nio40k/iBox-Printers-Nano/Nano ibox folder/www/packages/compressed/_svg/beam10cm_standing10x.stl

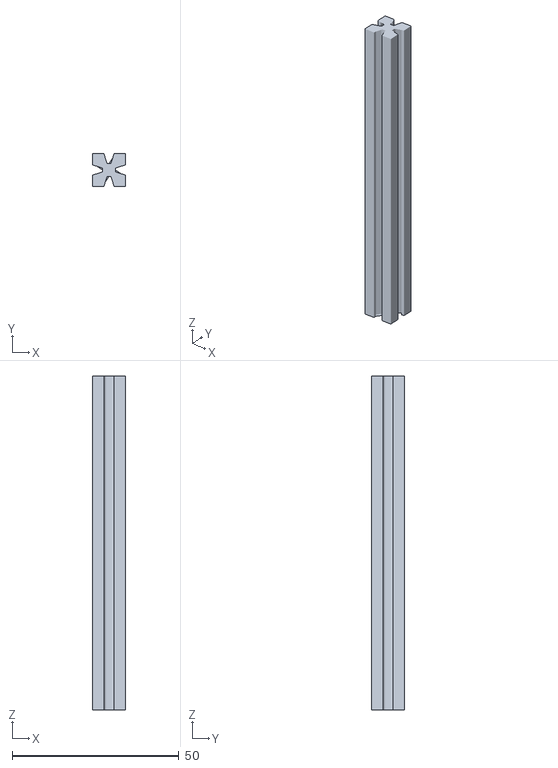
[picture p1: CAD file, 2016-02-06]
Nano ibox folder/www/packages/compressed/_svg/beam10cm_standing10x.stl
10.0 x 10.0 x 100.0
