nio40k/iBox-Printers-Nano/PCB Files/RLCD_SCH_28LED_v1p13p2.dxf

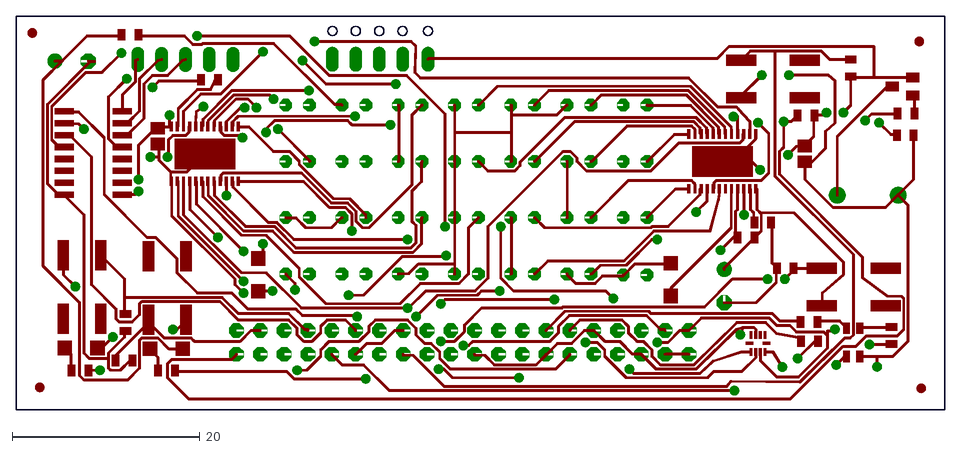
[picture p2: CAD file, 2016-02-06]
PCB Files/RLCD_SCH_28LED_v1p13p2.dxf
99.0 x 42.0
