nio40k/iBox-Printers-Nano/(list of files, cad)

Other CAD files:
Nano ibox folder/www/packages/compressed/_svg/.AppleDouble/beam10cm_standing10x.stl
Nano ibox folder/www/packages/compressed/_svg/.AppleDouble/linkBracelet_Fine.stl
Nano ibox folder/www/packages/compressed/_svg/.AppleDouble/OwlReDo1_fixed_sc.stl
