nio40k/iBox-Printers-Nano/Nano ibox folder/help/User_Instruction_Draft_2_5_15.htm

iBox Nano - User Guide

Updated 2/15/2015

Warnings:

The only way to damage the nano under normal operation is to spill resin on or in it.

What do I do if I spill resin on the printer?

Quickly remove the VAT and wipe off the resin with an absorbent paper towel or other cloth. You can use Alcohol to clean it. The more pure the Alcohol the better.

We have only damaged one Nano during thousands of test prints and that was by overfilling the VAT just a little too much and then not noticing it was overflowing during the first layer. Please under-fill the VAT. It is very easy to add resin with your 100mL squirt top resin bottles and difficult to remove resin. If we work together we can get through your natural fear of running out of resin. Once you are familiar with the printer it will be a non-issue.

Always clean the VAT bottom (underside where the VAT touches the top of the printer) and sides to make sure you do not have residual resin that will bond during a print. If you have or spill resin between the VAT bottom and printer top it will bond the two together during your print cycle. This is bad but usually not destructive. Remember that cured resin is basically a powerful glue.

What if I spill resin inside my Nano?

This is very bad. The resin will “cure” and bond everything together. Think of it as spilling superglue inside the printer. The buttons will be the first failure. The acrylic will discolor from the resin as well. The printer will likely still function from the GUI.

Safety:

What if I get resin on my hands?

Just wash them immediately.

Always wear eye protection when working with resin or any fluid that is not eye friendly. Please read the MSDS. Resin is generally safe, but be careful especially around children.

The MSDS (Material Safety Sheet) can be found here: http://www.makerjuice.com/docs/SubGPlus-MSDS.pdf

## I don't like reading, can I just watch how-to videos and stuff?

www.youtube.com/iboxprinters

## Where do I go for support if this incredible documentation incredibly fails me?

support.iboxprinters.com

We handle support through our support forum. Please let us explain why calling or sending us support email is less productive than a managed support forum:

1. Phone Support: Phone calls just piss everyone off. You wait on the phone just long enough to be fuming by the time we answer. The phone support staff get abused more than (insert inappropriate metaphor here). But the bottom line is that one person is helped, the wait time is long and uncontrollable, the service level is moderate at best.

2. Email Support: Email is at least asynchronous. You send it when you get a chance, we respond when we get a chance. All good so far. But email only helps 1:1 and knowledge is lost. Also delays in email support are usually only guaranteed at 24hr turn-around.

3. Forum Support: (our selected method): With a moderated support forum you can first search for your issue and if its common you could have an answer in seconds and be on your merry way. If you don't find a solution you can post a “new” question. Then the moderators and other friendly and helpful users can try to provide support and assistance. Your help session is logged for others to see and possibly be helped as well. The next big advantage to a support forum is search engine indexing. Thus people just banging in their issue in “google” can find the answer and find our support forum in seconds. This is what we like when we buy something and what we prefer when looking for support for our consumer electronic devices. We hope you join the forum and are happy with it. support.iboxprinters.com

General Operational Procedures:

1. Never fill the VAT more than half full with resin.

2. Seriously; Never fill the VAT more than half full with resin.

3. Always attempt to shut the Nano down gracefully if possible. It is a computer with an SSD and repeated “hard” power drops will reduce the devices reliable operation. Gracefully shutdown can be achieved from the GUI (Power Button) or by pressing and holding both theUP and DOWN buttons for >4 sec until it beeps multiple times. Shutdown takes 30-45 seconds, so watch the lights to make sure they have stopped blinking.

4. The network settings are displayed during boot time for N seconds - on the top of the printer where the VAT is placed. So until you are familiar with the Nano, specifically how to communicate with it, do not have the VAT in place while the printer is booting.

5. The Nano takes about 2 minutes to boot up after connecting USB power. It will beep and cycle all indicator lights at boot.

6. The Nano takes about 30 seconds to power down after holding-UP+DOWN > 5sec OR using reboot or shutdown commands from the GUI (i.e. Power button). Please do not disconnect or interrupt the shutdown process, you should wait until the Green LED on the lowest layer of the printer turns off.

7. The Nano has a microB USB plug and cable, but it is used only to power the unit. It will not enumerate on your computer as a USB device. All connectivity is achieved via WiFi.

8. You can power the Nano from almost any USB power source.

9. The Z axis on the nano has a Carriage that holds the Build Plate. The Build Plate needs to be lowered until it is touching the VAT surface before you initiate a Print. Try this a few times with no resin in the VAT to get comfortable with the process. Once you have “homed” this position and selected print, the position will be remembered. Once homed the Build Plate will lower to the print position by holding the “Down” button for several seconds until you hear a double beep. After a print completes the build plate will motor up automatically to a height that will allow easy removal of the Build Plate from the Carriage.

10. The buttons on the front of the Nano are multi-use:

Button [Print]:

• “quick press” -> (starts/stops printing) Starts a print. If a print is in process, it will stop the print job.

• “long press >4sec” -> Initiates WPS to associate with a WPS enable AP. See section on connecting the nano to the network.

• If “quick pressed” while the Carriage is in motion it will stop the Carriage motion.

Button [UP / DOWN]

• “quick press” -> Moves carriage UP / DOWN one layer height OR if the carriage is currently moving it will STOP the movement.

• “long press >1sec” -> Double Beeps -> Starts the carriage moving for a long distance (configurable in Nano GUI settings)

• Press BOTH UP+DOWN buttons for >4sec -> Gracefully shuts down the printer. You can also shutdown or reboot from the Nano GUI.

Getting your Nano on the network

## There are a few ways to get your Nano connected to the network:

• WPS - Pressing the WPS button on your Access Point (assuming it has this feature) and then pressing and holding the “Print” button on the Nano until you hear multiple beeps will put both devices in WPS mode and they should automatically connect.

• USB Stick : Rebooting with a USB Stick in the Nano with a minimum of the file wpa_supplicant.conf.txt that has been edited to include your network information.

• GUI+WiFi : Connect the Nano to a monitor [HDMI or Composite NTSC], and insert a USB Hub with [Keyboard, Mouse, WiFi adapter (from the Nano)]. Then just use the Nanos GUI to input your WiFi SSID and Passphrase/Key. The heart of the Nano is the Raspberry Pi, and there are hundreds of articles and youtube videos on getting it on the network.

• GUI + USB Ethernet Module : Connect the Nano to a monitor [HDMI or Composite NTSC], and insert a USB Hub with [Keyboard, Mouse, Ethernet USB adapter (User Supplied - Make sure it is one that works easily with a Raspberry Pi)]. Then just use the Nanos GUI to verify you are connected via Ethernet via your Ethernet LAN. You can actually do this without accessing the GUI if the Raspberry Pi recognizes your ethernet adapter and has drivers for it. If so you can just boot the Nano with the Ethernet adapter inserted in the USB port and the IP address will display on the Nanos screen (where the VAT goes).

## Configure WiFi VIA : USB Memory Stick:

Start with he Nano OFF (not connected to USB power). Now put the USB stick in the iBox Nano’s USB port. This will require you to first remove the WiFi adapter. Now reboot. Let the Nano fully reboot ~<3min. Then remove the USB memory stick and reinsert the WiFi USB module. Now reboot the Nano again. The Nano should gain access to your network and display its IP address and other information on the screen during the next reboot.

Download these files and put them on a USB stick formatted as FAT (typical format)

• wpa_supplicant.conf.txt (mandatory) -> Add your access point SSID + Key

• hosts.txt (optional) -> Set Nano’s network name - Default in the Nano is “Nano”. You do not have to change this name unless you have multiple Nanos on your network and you want to use ZeroConfig. If you have one Nano you can use ZeroConfig with the default name.

• hostname.txt (optional) -> Set Nano’s network name (second place it needs to be set. Needs to match the “name” in hosts.txt.

• interfaces.txt (optional) -> Set Nano’s advanced network properties

Only one of these files needs to be changed to get the Nano on your WiFi network. The other three are for setting the Nano’s network name (handy if you have several iBox Nanos), and for advanced users.

wpa_supplicant.conf.txt:

Example 1. Your home/work Access Point has an SSID of “HomeAP” and Passphrase of “1234567890”

Add this to the wpa_supplicant.config.txt file on the USB stick: (you can just cut and paste it)

ctrl_interface=DIR=/var/run/wpa_supplicant GROUP=netdev

update_config=1

network={

ssid=“your_ap_name”

psk="1234567890"

proto=RSN

key_mgmt=WPA-PSK

pairwise=CCMP

auth_alg=OPEN

}

NOTES:

You need to change ssid=“your_ap_name” to your WiFi SSID
You need to change psk=“1234567890” to your APs Key/passphrase

You might have to change pairwise=CCMP to TKIP if so you need to add a new line:

pairwise=TKIP

group=TKIP WEP104 WEP40

## Configure WiFi VIA : WPS:

The second way to setup the WiFi network is a fairly recent feature called WPS. WPS allows you to press a button on your Access Point and a button on a device within a short period ~1-2minutes and have them associate with each other. On the Nano the WPS button is accessed by holding the “Print” button (front - right button) for 5 seconds. You will hear several “beeps”. Now press the WPS button on your Access Point. They should now be linked. You can find the network information on the Nano’s screen at every reboot and after a successful WPS connection. Please note the IP address from the Nano’s screen during one of these events It is how you will connect to the Nano.

For more advanced users you can create a DHCP reservation for the Nano once it is associated with your Access Point. This is done on the AP and the process varies from AP to AP. This will assure your Nano always has the same IP Address. This process is recommended but optional.

## Configure WiFi VIA : GUI (Keyboard, Mouse, Monitor/TV):

With the Nano powered OFF; Remove the Nanos WiFi USB interface and insert a powered USB Hub. I needs to be powered because the WiFi adapter requests all of the power available from the USB port, thus the KB, Mouse and WiFi adapter will not likely work on a passive (unpowered) USB hub. Now plug in any mouse, keyboard and your WiFi USB adapter you removed from the Nano. Now boot the Nano.

Your TV or Monitor should show the Nano booting and eventually its GUI. From the GUI select the WiFi configuration tool from the top left quick launch bar. If the wireless card is not enumerated in the dropdown list you likely have a USB Hub issue. You can still configure the Nano even without the WiFi adapter enumerated. Just edit the wpa_configuration.conf file with your network information, then save it. Its much easier/faster if the WiFi USB adapter enumerates.

How do you connect to your Nano once its on a WiFi network?

### Get the IP Address of the Nano. This can be done two ways.

• Power up the Nano, the IP Address will be on the top Nano screen for a few seconds

• Access your Access Points list of associated clients, the IP address will also be listed.

From any browser, type the IP address of the nano in the URL bar: http://xxx.xxx.xxx.xxx where the “xxx” are the IP address you noted on the Nano’s screen.. i.e. http://192.168.1.110 you will do this where it might normally say http://www.yahoo.com or http://www.google.com.

You can also connect to your Nano using ZeroConfig

Browser: iboxnano.local

SSH: ssh pi@iboxnano.local

VNC: iboxnano.local:1

Windows FileManager: iboxnano.local

Mac-Finder-Connect to server: iboxnano.local

ZeroConfig allows the user to connect to the iBox Nano from a browser using http://iboxnano.local instead of http://xxx.xxx.xxx.xxx where xxx is the IP address of the Nano if you happen to be using a device that supports ZeroConfig such as Windows, Mac, iPhone, iPad, etc. Now you can connect both ways from most computers. Some atypical computing devices may still require using the IP address.

ZeroConfig can also be used to map the Nano’s drive as a network drive. This can be handy to move files back and forth between a Windows or Mac.

Why is ZeroConfig important?

Because on some networks the Nanos IP address will change periodically because by default the Nano uses DHCP (Dynamic Host Configuration Protocol) which [can] rotate IP addresses. Thus the IP of you nano may change periodically. With ZeroConfig this IP change has no affect on the ease of connectivity. Also note that Zeroconfig should also allow connectivity to your Nano via SSH and VNC for the advanced users

Awesome I am connected to the Nano, now how do I print something?

### Finding and formatting a 3D model can be easy or quite complex. Lets start by printing a model that is already stored on the Nano.

1. Go to a browser on a Windows, Mac, Phone, and connect to the printer by its IP address. You will see the printers Graphical User Interface (GUI) which also happens to be a web page.

2. Click “Select File To Print”, then select the drop-down list of models already downloaded and configured for the Nano’s print area.

3. Press “Select File”, this will bring you back to the main Nano GUI Home Screen.

4. Before we can hit print we need to add resin to the VAT and position the build platform.

A. Put your VAT in the printer and lightly tighten the 4x philips head screws.

B. Carefully and Slowly fill the VAT about half way full. If you overfill it, remove resin. This may be done by siphoning off resin or removing the VAT and poring out the resin.

C. Now press and hold the “Down” button on the printer until it beeps twice. This is a long movement. A quick press is a small movement of one layer in height. There is also a GUI button for UP, DOWN and STOP. All long movements. The printer will Beep when the long movement has stopped. The goal is to get the Build Plate all the way down and completely touching the VAT. This is the print ready position. Watch carefully as the Build Platform is moving down. Make sure the Resin is not going to overflow onto the printer. If it looks like it might overflow from the Build Plate displacing too much resin, press the UP or DOWN button again to stop the movement, then remove some resin.

5. Press “Print”, this will initiate the print process. Within a minute or so the display will update with estimated print times, number of layers to print, etc. It will continue to update periodically during the print process.

## So you printed a Bunny (or other pre-loaded models). Now you want to download something.

1. Start by looking through our models on models.iBoxPrinters.com our account on Thingiverse and selecting models that we have successfully printed. Get familiar with the printer before trying to create your own models or print models that are not yet formatted of the Nano.

https://www.thingiverse.com/iBoxPrinters/makes

2. Select an item and press “download”. This downloads it to the device you are using, not the Nano.

3. If the item is formatted for the Nano, you can press “Upload File” from the Nano GUI.

4. Press “Choose Files”, select the file you downloaded

5. Press “Upload”, this takes the file from your computing device and uploads it to the Nano. This step also selects it to be printed, so you do not need to press “Select file to print”

6. Make sure you have resin in the VAT (less than half full)

7. Lower the Build Plate to the print position by pressing “Down” (Build Plate touching VAT - Its the lowest position for the build plate). If you press down on the printer, press and hold it until it double beeps. If on the GUI a quick press is fine. The GUI always moves a large distance, the physical button on the printer has two modes. Quick touch->Moves only one layer Up or Down. Long_Press->Moves a large distance. Pressing any button during a long move will halt the move process.

How do I format someone else STL file for the Nano?

1. Download the STL to your computing device

2. Download and Launch Slic3r (free)

3. Configure Slic3r’s build area to 40x20mm

1. Printer Settings (in Slic3r)

2. Bed Shape -> Set to x=40 y=20, origin x=0 y=0 : rectangular

4. Open the STL in Slicer

5. Scale the object to fit the 40x20 build area

6. Make sure the object is touching the bottom of the build area.

7. Save the STL

8. Select File->Slice to SVG from the Slic3r menu

9. Go to the Nano GUI, press “Upload File” then “Choose Files”

10. Select the SVG you just created, then press “Upload”

11. Now you are ready to print: Just fill VAT <1/2 full. Lower build plate until it is touching VAT

12. Press “Print” on the Nano GUI home screen.

## What is in an iBox Model Library?

An iBox Model Library [.IML] file is a compressed group of files that incorporates all of the necessary information to print a model on an iBox Printer.

It contains:

-(mandatory) : Package Information File. This file is a JSON formatted information file that tells the iBox Printer what is in the IML and what to do with it. This file is extensible, like XML.

-(mandatory) : Layer Images 0000 - NNNN. These are the actual Layer image files. Their format depends on the printer in question. On the Nano they are formatted as 128x64 PNG Images. Each image represents a layer to be printed. This list has zero base, so the first layer is Layer_Name_0000.png. If you had 100 layers, the last image name would be Layer_Name_0099.png.

-(optional) : Suggested Print Configuration Profile : This is the same as the profiles you create and use from the “Settings” area of the GUI. The main goal here is to provide a known good baseline for others to use to be able to print the Model successfully.

-(optional) : The STL that was used to create the IML

-(optional) : Print Sample in .jpg, preferably a reasonable size.

Example IML Archive : 4 Layer Gear (most models will be 100-400 layers) - Mandatory files BOLD

Four_Layer_Gear.IML (compressed archive)

[ Uncompressed Contents ]

Four_Layer_Gear.PIF

Four_Layer_Gear_Config.json

Four_Layer_Gear_0000.png

Four_Layer_Gear_0001.png

Four_Layer_Gear_0002.png

Four_Layer_Gear_0003.png

Four_Layer_Gear_Preview.jpg

Four_Layer_Gear.stl

How do I transfer files to and from my Nano?

### There are several ways to facilitate moving files to and from your Nano:

Use the Nano’s web GUI Upload button. This is designed to upload print files (SVG, etc) to the Nano, not for general file transfer.

Map a network drive from Windows. Linux or Mac. This process varies from version to version and OS to OS. You can map the Nano’s file system by connecting to the Nano from your File manager like you would any other computer to computer connection. To address the Nano you can use its IP Address or its ZeroConfig name. i.e. 192.168.1.100 OR iboxnano.local

Windows: File Manager : Map Network Drive : [IP Address / or / iboxnano.local]

Mac OSX : Finder : Go : Connect to server : iboxnano.local / or / IP Address

## Can I put my own WiiFi USB adapter or Ethernet adapter in the Nano?

Sure; just make sure it is one that is known to work with the Raspberry Pi, preferably without having to install drivers. If drivers need to be installed you will need to either download the files via the factory Nano WiFi module OR via a USB stick.

## Do you have a list of known-working Ethernet Adapters?

Although iBox does not maintain a list, there is one here: http://elinux.org/RPi_USB_Ethernet_adapters

## Do you have a list of known-working WiFi Adapters?

Although iBox does not maintain a list, there is one here: http://elinux.org/RPi_USB_Wi-Fi_Adapters

## What OS is installed on the Nano’s Raspberry Pi?

This can and will vary. Raspbian from Jan 2015. If you SSH to the Nano or use the GUI from VNC or HDMI and launch Terminal: run: cat /proc/version

Result as of Feb 2015: Linux version 3.18.5+ (dc4@dc4-XPS13-9333) (gcc version 4.8.3 20140303 (prerelease) (crosstool-NG linaro-1.13.1+bzr2650 - Linaro GCC 2014.03) ) #744 PREEMPT Fri Jan 30 18:19:07 GMT 2015
