nio40k/iBox-Printers-Nano/Nano ibox folder/images/Backgrounds/iBox_Printers_400x233.png

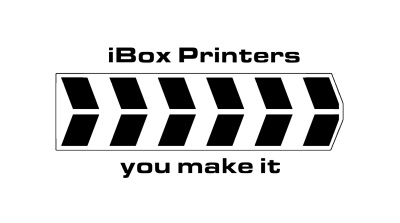
Nano ibox folder/images/Backgrounds/iBox_Printers_400x233.png
