nio40k/iBox-Printers-Nano/Nano ibox folder/www/help/Nano_Quick_Start_Guide.png

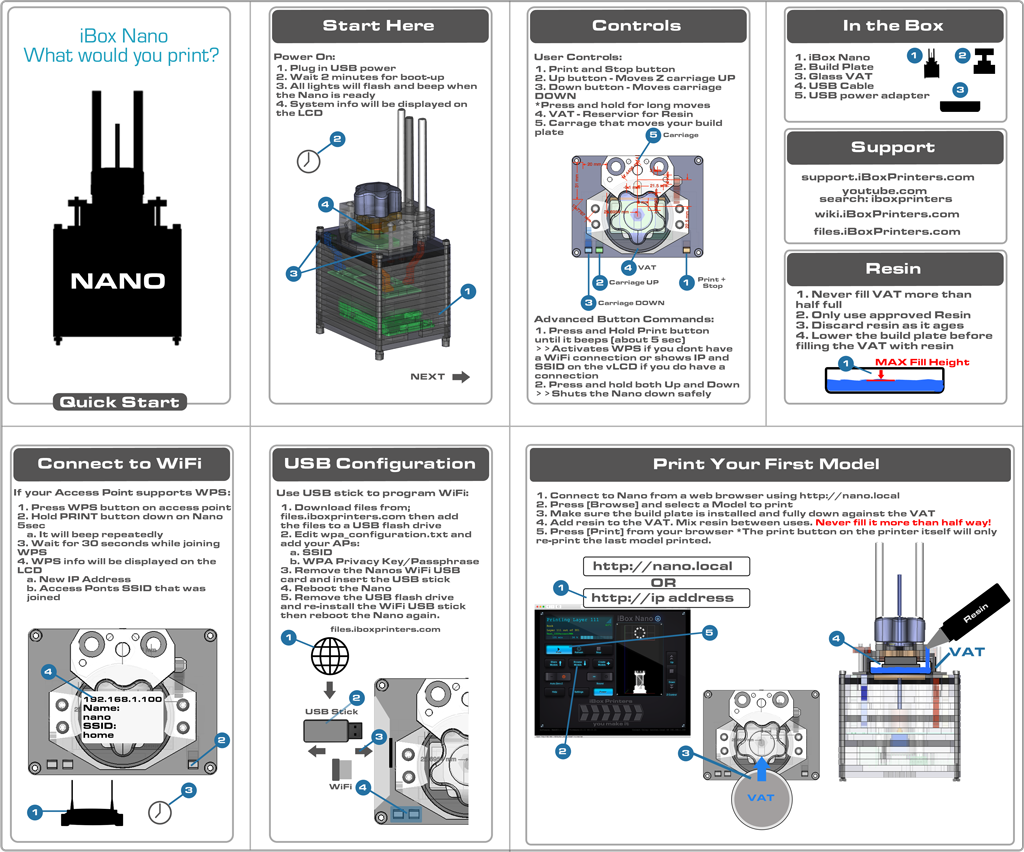
Nano ibox folder/www/help/Nano_Quick_Start_Guide.png
