nio40k/iBox-Printers-Nano/Nano ibox folder/www/model_images/mgnt/makerook_small.jpg

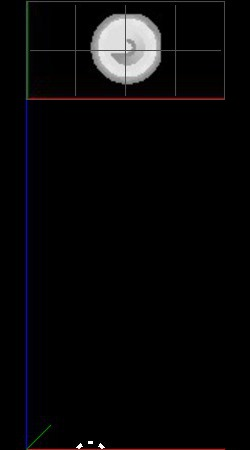
Nano ibox folder/www/model_images/mgnt/makerook_small.jpg
