nio40k/iBox-Printers-Nano/Nano ibox folder/www/packages/expanded/Test_Print_TextThr1p/_front.jpg

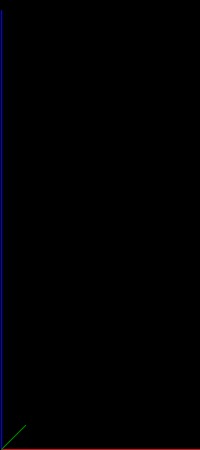
Nano ibox folder/www/packages/expanded/Test_Print_TextThr1p/_front.jpg
