nio40k/iBox-Printers-Nano/Nano ibox folder/www/model_images/thumb_finger_test_30p.jpg

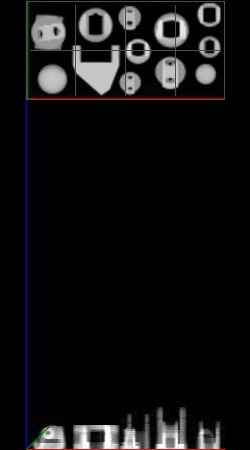
Nano ibox folder/www/model_images/thumb_finger_test_30p.jpg
