nio40k/iBox-Printers-Nano/Nano ibox folder/www/packages/expanded/thumb_finger_test_30p/_front.jpg

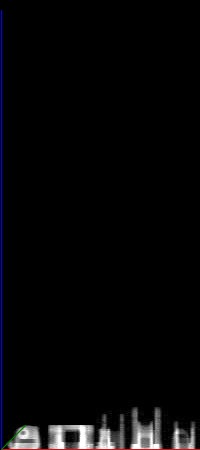
Nano ibox folder/www/packages/expanded/thumb_finger_test_30p/_front.jpg
