nio40k/iBox-Printers-Nano/(list of files, drawings)

Other design files:
PCB Files/ConvertToAltium/Imported RLCD_SCH_28LED_v1p13p2.PrjPcb/PCB Pannalized.PcbDoc
PCB Files/ConvertToAltium/Imported RLCD_SCH_28LED_v1p13p2.PrjPcb/RLCD_SCH_28LED_v1p13p2.PcbDoc
PCB Files/ConvertToAltium/Imported RLCD_SCH_28LED_v1p13p2.PrjPcb/RLCD_SCH_28LED_v1p13p2.PrjPcb
PCB Files/ConvertToAltium/Imported RLCD_SCH_28LED_v1p13p2.PrjPcb/RLCD_SCH_28LED_v1p13p2.SchDoc
PCB Files/PCB1.PcbDoc
PCB Files/RLCD_SCH_28LED_v1p13p2.pcb
PCB Files/RLCD_SCH_28LED_v1p13p2_1.SchDoc
