nio40k/iBox-Printers-Nano/PCB Files/RLCD_SCH_28LED_v1p13p2.brd

## EAGLE design PCB Files/RLCD_SCH_28LED_v1p13p2.brd (2016-02-06)

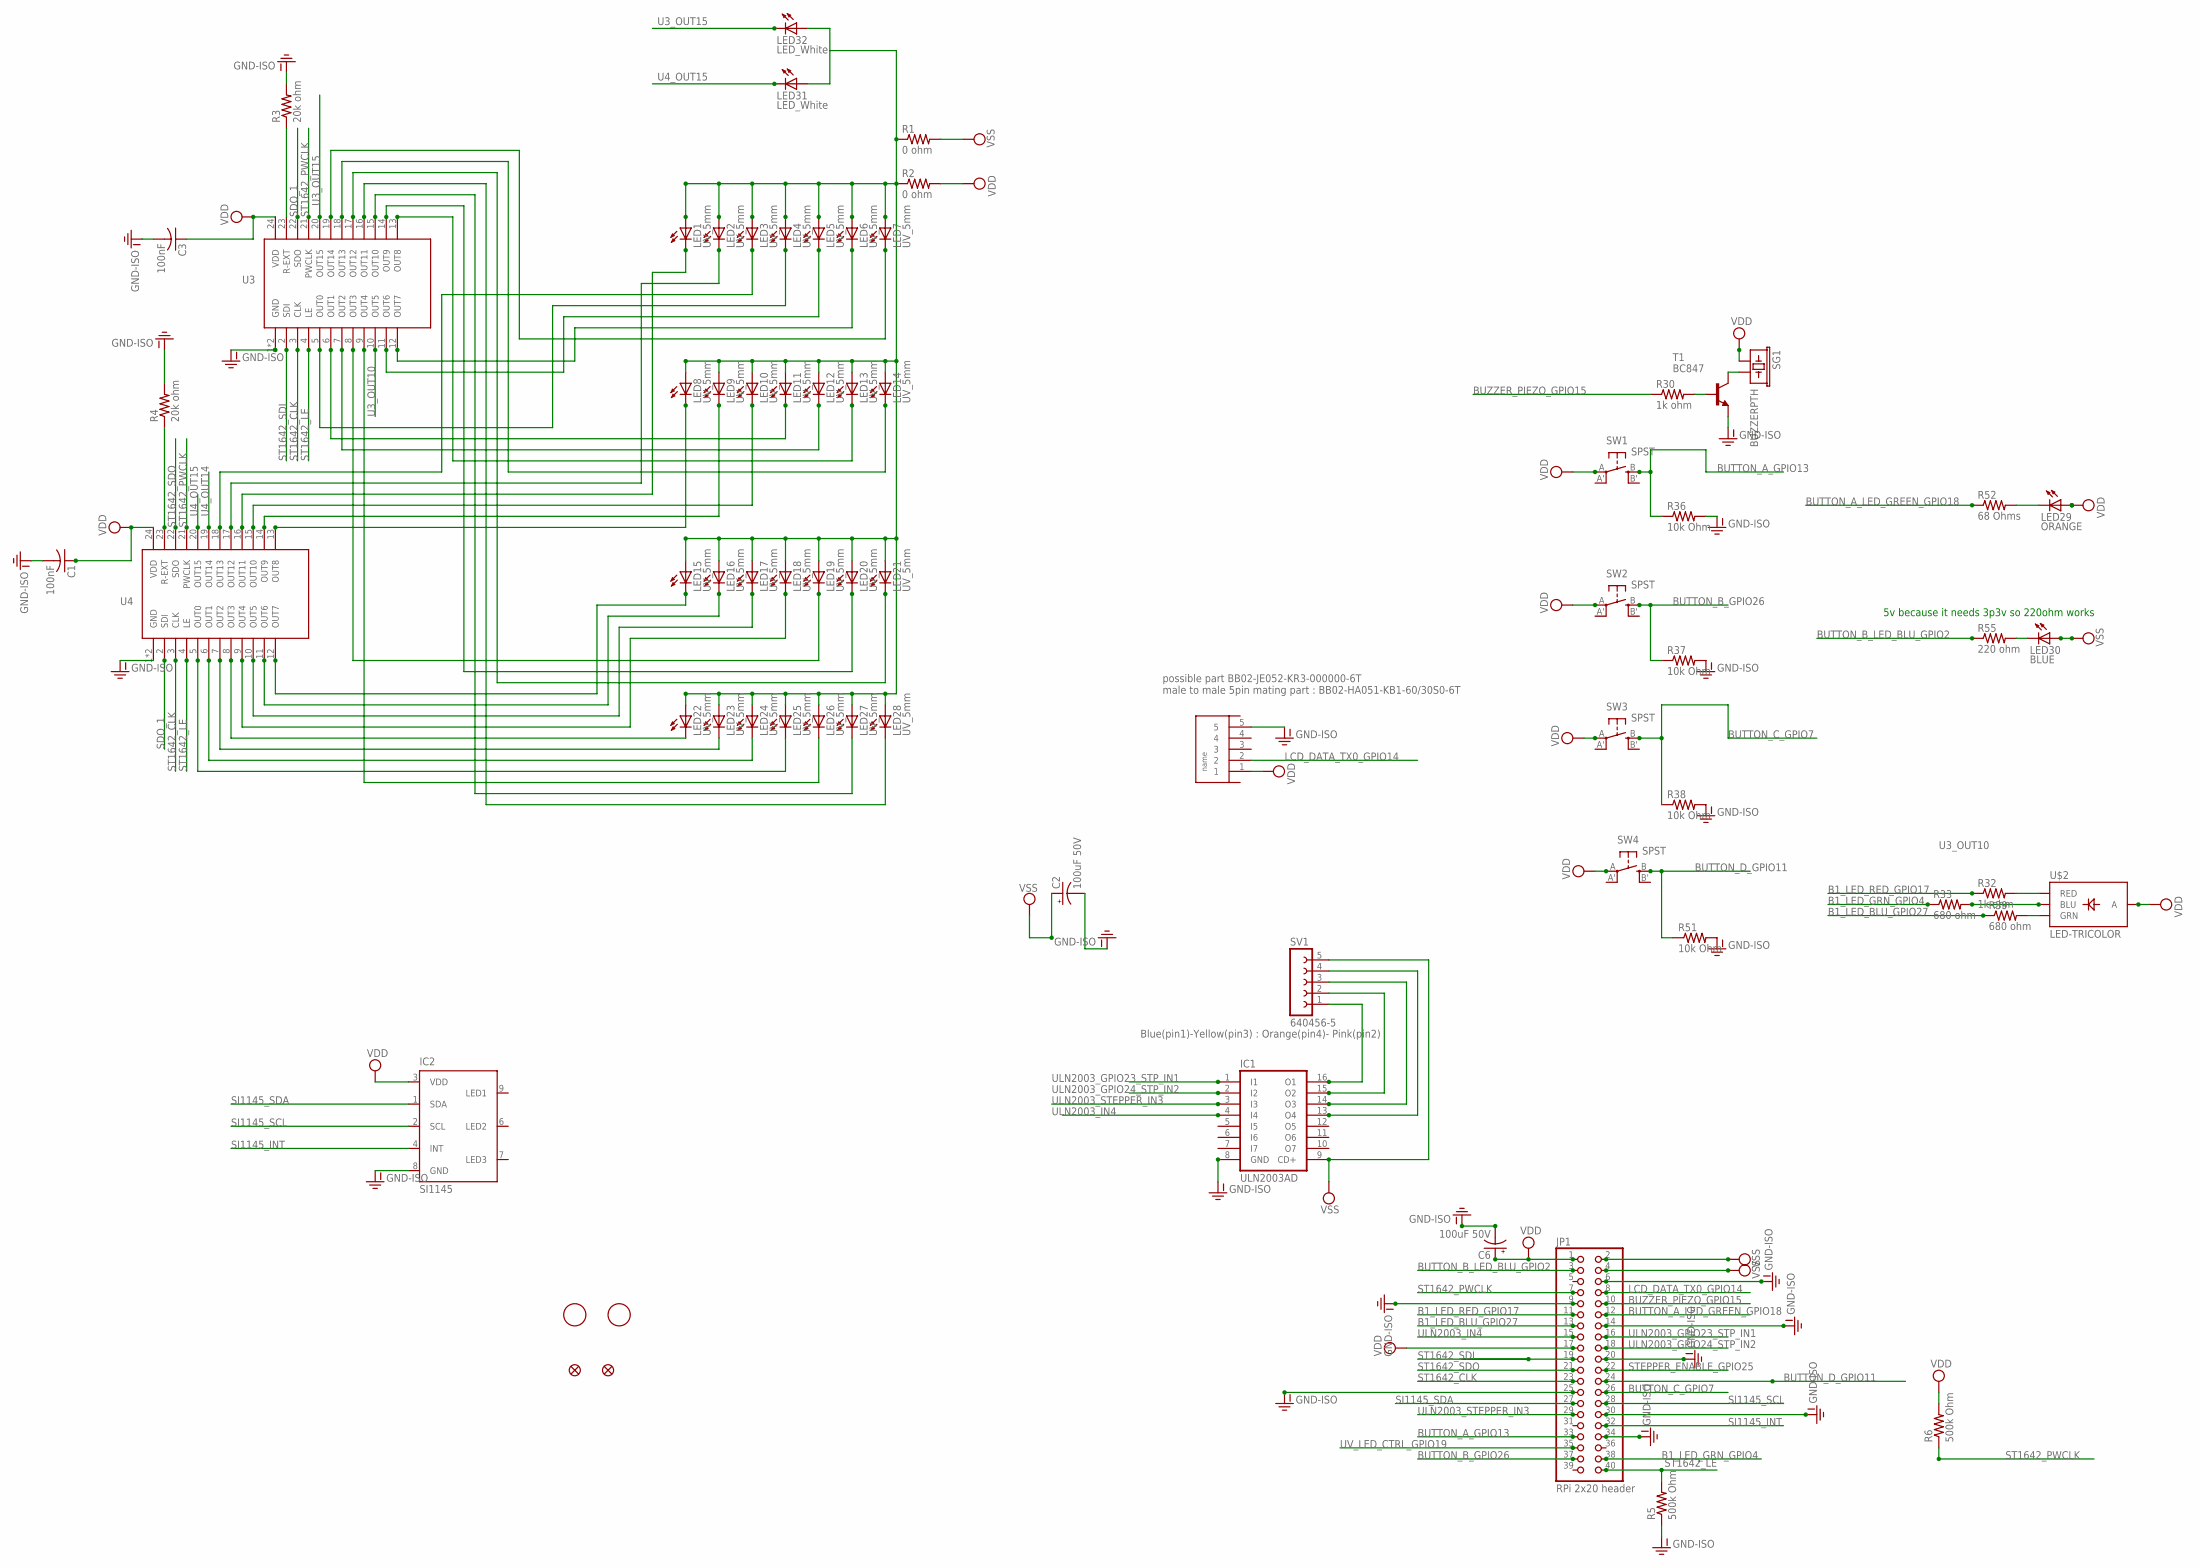
[picture p10: schematic RLCD_SCH_28LED_v1p13p2.sch]

Parts:
C1, C3: 100nF; C0805
C2, C6: 100uF 50V; E3,5-8; PARTNO REA101M1HBK-0811P
FID1, FID2: FIDUCIAL1X2; FIDUCIAL-1X2
IC1: ULN2003AD; SO16
IC2: SI1145; QFN-10
JP1: RPi 2x20 header; 2X20; PARTNO 929975-01-13-RK
LED1, LED2, LED3, LED4, LED5, LED6, LED7, LED8, LED9, LED10, LED11, LED12, LED13, LED14, LED15, LED16, LED17, LED18, LED19, LED20, LED21, LED22, LED23, LED24, LED25, LED26, LED27, LED28: UV_5mm; LED5MM; PARTNO *
LED29: ORANGE; CHIPLED_1206; PARTNO LG N971-KN-1
LED30: BLUE; CHIPLED_1206; PARTNO LTST-C21TBKT
LED31, LED32: LED_White; CHIPLED_1206; PARTNO LG N971-KN-1
R1, R2: 0 ohm; 0805; PARTNO DNP
R3, R4: 20k ohm; 0805; PARTNO DNP
R5, R6: 500k Ohm; 0805; PARTNO RK73B2ATTD103J
R30, R32: 1k ohm; 0805; PARTNO RK73H2ATTD1001F
R33, R39: 680 ohm; 0805; PARTNO RK73B2ATTD681J
R36, R37, R38, R51: 10k Ohm; 0805; PARTNO RK73B2ATTD103J
R52: 68 Ohms; 0805; PARTNO RK73B2ATTDD121J
R55: 220 ohm; 0805; PARTNO RK73B2ATTD221J
SG1: BUZZERPTH; BUZZER-12MM; PARTNO AT-1220-TT-R
SV1: 640456-5; FE05-1; PARTNO 640456-5
SV3_LCD_HEADER: 22-05-2051; MDF7-5S-2.54DSA; PARTNO MDF7-5S-2.54DSA(55)
SW1, SW2, SW3, SW4: SPST; EVQ-Q2
T1: BC847; SOT23; PARTNO MMUN2214LT1G
U$1, U$5: FIDUCIAL; FIDUCIAL_1MM
U$2: LED-TRICOLOR; LED-TRICOLOR-SMD; PARTNO CLV1A-FKB-CHMKPEHBB7A363
U$3, U$4: LED1642GWTTR; TSSOP24

Connections:
B1_LED_BLU_GPIO27: JP1.13, R39.1
B1_LED_GRN_GPIO4: JP1.38, R33.1
B1_LED_RED_GPIO17: JP1.11, R32.1
BUTTON_A_GPIO13: JP1.33, R36.1, SW1.B (S)
BUTTON_A_LED_GREEN_GPIO18: JP1.12, R52.1
BUTTON_B_GPIO26: JP1.37, R37.1, SW2.B (S)
BUTTON_B_LED_BLU_GPIO2: JP1.3, R55.1
BUTTON_C_GPIO7: JP1.26, R38.1, SW3.B (S)
BUTTON_D_GPIO11: JP1.24, R51.1, SW4.B (S)
BUZZER_PIEZO_GPIO15: JP1.10, R30.1
GND-ISO: C1.2, C2.-, C3.2, C6.-, IC1.8 (GND), IC2.8 (GND), JP1.6, JP1.9, JP1.14, JP1.20, JP1.25, JP1.30, JP1.34, R3.2, R4.2, R5.1, R36.2, R37.2, R38.2, R51.2, SV3_LCD_HEADER.5, T1.2 (E), U$3.1 (GND), U$3.P$100 (GND), U$4.1 (GND), U$4.P$100 (GND)
LCD_DATA_TX0_GPIO14: JP1.8, SV3_LCD_HEADER.2
LED+: LED1.A, LED2.A, LED3.A, LED4.A, LED5.A, LED6.A, LED7.A, LED8.A, LED9.A, LED10.A, LED11.A, LED12.A, LED13.A, LED14.A, LED15.A, LED16.A, LED17.A, LED18.A, LED19.A, LED20.A, LED21.A, LED22.A, LED23.A, LED24.A, LED25.A, LED26.A, LED27.A, LED28.A, LED31.A, LED32.A, R1.1, R2.1
unnamed: LED2.K (C), U$4.17 (OUT12)
unnamed: LED3.K (C), U$4.18 (OUT13)
unnamed: LED6.K (C), U$3.12 (OUT7)
unnamed: LED4.K (C), U$3.5 (OUT0)
unnamed: LED5.K (C), U$3.11 (OUT6)
unnamed: LED22.K (C), U$4.8 (OUT3)
unnamed: LED15.K (C), U$4.12 (OUT7)
unnamed: R3.1, U$3.23 (R-EXT)
unnamed: LED16.K (C), U$4.11 (OUT6)
unnamed: LED17.K (C), U$4.10 (OUT5)
unnamed: LED18.K (C), U$4.9 (OUT4)
unnamed: R4.1, U$4.23 (R-EXT)
unnamed: LED19.K (C), U$3.8 (OUT3)
unnamed: LED11.K (C), U$3.6 (OUT1)
unnamed: LED9.K (C), U$4.14 (OUT9)
unnamed: LED10.K (C), U$4.15 (OUT10)
unnamed: LED20.K (C), U$3.14 (OUT9)
unnamed: LED12.K (C), U$3.7 (OUT2)
unnamed: R39.2, U$2.G (GRN)
unnamed: LED14.K (C), U$3.18 (OUT13)
unnamed: LED21.K (C), U$3.17 (OUT12)
unnamed: LED23.K (C), U$4.7 (OUT2)
unnamed: LED24.K (C), U$4.6 (OUT1)
unnamed: LED25.K (C), U$4.5 (OUT0)
unnamed: LED26.K (C), U$3.9 (OUT4)
unnamed: LED27.K (C), U$3.15 (OUT10)
unnamed: LED28.K (C), U$3.16 (OUT11)
unnamed: LED13.K (C), U$3.13 (OUT8)
unnamed: R30.2, T1.1 (B)
unnamed: IC1.13 (O4), SV1.4
unnamed: SG1.- (2), T1.3 (C)
unnamed: LED7.K (C), U$3.19 (OUT14)
unnamed: R33.2, U$2.B (BLU)
unnamed: IC1.14 (O3), SV1.3
unnamed: LED29.C, R52.2
unnamed: LED30.C, R55.2
unnamed: LED8.K (C), U$4.13 (OUT8)
unnamed: LED1.K (C), U$4.16 (OUT11)
unnamed: IC1.16 (O1), SV1.1
unnamed: IC1.15 (O2), SV1.2
SDO_1: U$3.22 (SDO), U$4.2 (SDI)
SI1145_INT: IC2.4 (INT), JP1.32
SI1145_SCL: IC2.2 (SCL), JP1.28
SI1145_SDA: IC2.1 (SDA), JP1.27
ST1642_CLK: JP1.23, U$3.3 (CLK), U$4.3 (CLK)
ST1642_LE: JP1.40, R5.2, U$3.4 (LE), U$4.4 (LE)
ST1642_PWCLK: JP1.7, R6.1, U$3.21 (PWCLK), U$4.21 (PWCLK)
ST1642_SDI: JP1.19, U$3.2 (SDI)
ST1642_SDO: JP1.21, U$4.22 (SDO)
STEPPER_ENABLE_GPIO25: JP1.22
U3_OUT10: R32.2, U$2.R (RED), U$3.10 (OUT5)
U3_OUT15: LED32.C, U$3.20 (OUT15)
U4_OUT14: U$4.19 (OUT14)
U4_OUT15: LED31.C, U$4.20 (OUT15)
ULN2003_GPIO23_STP_IN1: IC1.1 (I1), JP1.16
ULN2003_GPIO24_STP_IN2: IC1.2 (I2), JP1.18
ULN2003_IN4: IC1.4 (I4), JP1.15
ULN2003_STEPPER_IN3: IC1.3 (I3), JP1.29
UV_LED_CTRL_GPIO19: JP1.35
VDD: C1.1, C3.1, C6.+, IC2.3 (VDD), JP1.1, JP1.17, LED29.A, R2.2, R6.2, SG1.+ (1), SV3_LCD_HEADER.1, SW1.A, SW2.A, SW3.A, SW4.A, U$2.A, U$3.24 (VDD), U$4.24 (VDD)
VSS: C2.+, IC1.9 (CD+), JP1.2, JP1.4, LED30.A, R1.2, SV1.5

Notes on the sheet:
5v because it needs 3p3v so 220ohm works
Blue(pin1)-Yellow(pin3) : Orange(pin4)- Pink(pin2)
possible part BB02-JE052-KR3-000000-6T male to male 5pin mating part : BB02-HA051-KB1-60/30S0-6T

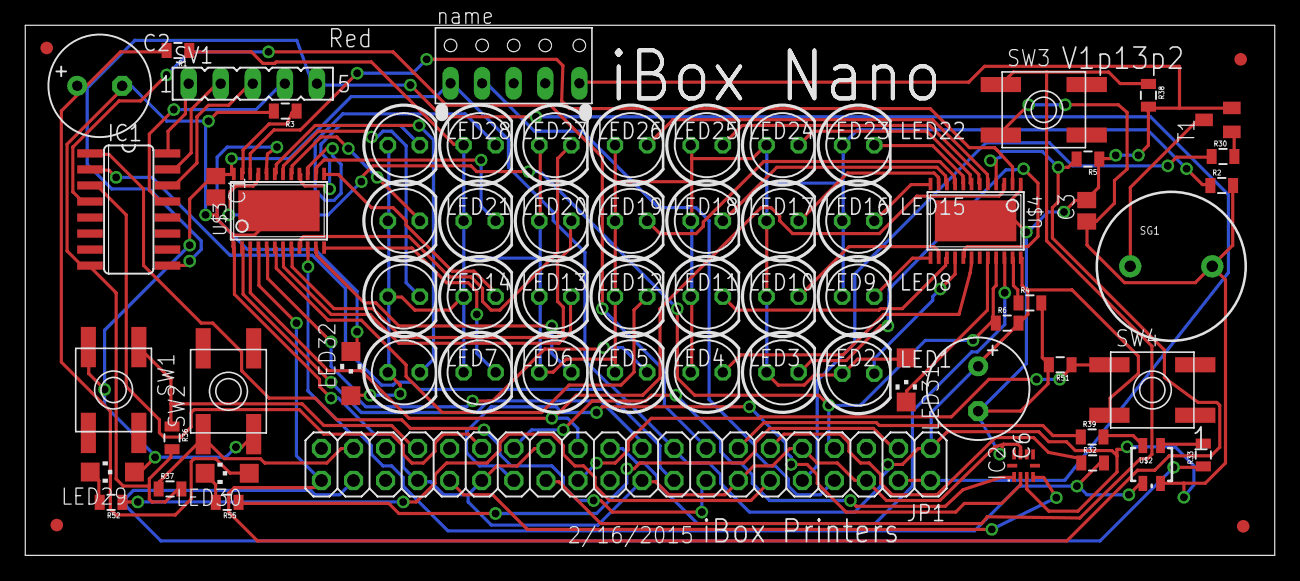
[picture p11: board RLCD_SCH_28LED_v1p13p2.brd from above]

Board: 2 copper layers, 99.0 x 42.0 mm, 70 parts (0 on the bottom side), 71 nets.
