nio40k/iBox-Printers-Nano/Nano ibox folder/iBoxPrintManager.py

#!/usr/bin/env python3


#print manager for BahnTech 3DLCD printer
#8/17/2014 from printmanager.py created 5/24/14
#9/26/2014 Total Re-Write to integrate with Node.js and add a browser based Client Side UI
#9/28/24 Migrated from Beta3s partial Node.js integration, picking it up in this file and on Beta4. Will switch to beta 5 ASAP (as soon as I populate a new PCB and cut Beta5)
#10/11/14 Trying to fix stepper random motion issue. PCB 1.6 in Beta 5
#11.29.2014 Adding ULN2003 Darlington Array driver for stepper
#11/30/14  ULN2003 working. Fixing LED ON to LED_ON and Long Hold code for Down and Up to release event and hold time.
#12/1/2014 Working on stepper studder using ULN2003
#12/4/14 Fixing iSteps_Per_100_Microns implemetiation issues
#12/6/14 Printing SSID, IP Address and local Host Name to LCD at BOOT
#12/7/14 Built Beta6 with Beta9-PCB
#12/8/14 Working Auto zero and LED code
#12/9/14 When the Limit switch is triggered, about 200-400 microns above 0, run the stepper down for 300 microns to make sure the build plate is on the VAT floor. Then step it back up one layer. i.e. 100 microns.
#12/10/14 Implementing Hold DOWN Print to invodke WPS (wifi auto connect) script wps.sh
#12/12-15/14 Working on SPI driver for ST LED1642 constant current LED driver. Works on PCB_11
#12/17/14 Added Init routine for LED1642 - Send SPI commands to set LED Current, and switch, brightness settings
#12/18/14 Adding Power myConfig param + Final integration of RPi A+ and PCB11 (1p12p13) in Beta 6 Chassis
#12/30/14 Adding Brightness control using LED1642: 2 parts: 1: Outputting a CLK into the Brightness_CLK (aka ST1642_PWCLK) pin on LED1642 on RPi_GPIO:4 aka GPIO GCLK 
#1/1/15 Happy New Year! : Initiated Pixel_Over_LED control of Brightness.aka POLB line 730 
#1/13/15 Back to PixelOverLED Control
#2/1/15 White Lite Integration
#2/9/15 Keey white LEDs oon for a while on boot but have them off during prints
#2/14/15 Bringing up Beta 12 with v1p12p30 PCB. Main difference from Beta10 PCV in Beta 5 unit is addition of I2C Photodiode (not yet implemented) and fully binned and equally radiating LEDs
#3/15/15 Changing stdin /button_sound handler. The toggle happens in node.js
#4/17/15 Updated remote update, added button lights for long press
#4/19/15 Adding Foundation Layers and Types
#5/2/15 Added UAP 3 : TRC
#5/4/2015 Fixed self.status_messages_to_GUI_3("KeyERR " + str(e) + " myConfig")  TRC
#5/4/2015 Adding iPrint_UV_Time_Per_LED
#5/4/2015 Fixed i = Number of layers in def print_ to exit for loop. This caused inaccurate time and LED use stats
#5/8/2015 Adding advanced MnT supporting multile ip_addresses (multiple MnT stations) and Adjust Iteration Count
#5/12/2015 added iPixel_Over_LED_Power
#5/13/2015 Verified file names comply with Linux requirements and added Beep stdio from Node

#This program accepts client requests via StdIn from Node.ja, services them, then provides a status_update to Node.js Via StdOut.
#Key Files:
#File Name : Function : Location
#iBoxPrintManager.py : Print manager, direct hardware control, SVG parser : Currently: /usr/share/adafruit/webide/repositories/my-pi-projects/iBox_Nano/ but for production: /home/pi/ibox/
#
#Changelog:
    #v1p5p0 = 9/4/2014 for new purple 1.5.3 PCBs. Added a Print button, changed lights on up and down from RGB to Green=down and Blue=Up. Print=RGB aka B1
#//  Moving to threads for spawned processes like Print, Move Z Up/Down 9/28/14



import os
import pygame
import time
import random
import socket #//  For "Pi Finder and ip address knowledge //
#import socketserver
import sys
import RPi.GPIO as GPIO #import GPIO Interface
from PIL import Image #For Image File I/O using PIL (aka Method ## 3 ##)
import itertools #to convert a bit stream to byte stream # For Image open to LCD ## 3 ## and bUse_ImgConvertType1Fcn
import numpy as np # For Image open to LCD ## 3 ## and bUse_ImgConvertType1Fcn and to average lists for PWM 
import select
import threading #from http://stackoverflow.com/questions/11758555/python-do-something-until-keypress-or-timeout
import xml.etree.ElementTree as ET  #  to parse XML, step 1 to use slic3rs SVG files
import subprocess # for calling Imagemagick from command line. Not sure if that will interfere with stdin/out to Node.js controlling Printmanager UI
import copy #for XML parsing of SVG files 9/29/14
import json #for json config file parsing
import urllib.request #for Remote Upgrade of software
import ast #for converting string to float
#import spidev #SPI for talking to ST LED1642 constant current chip
#import wiringpi2 #trying to get a MHz clk out of GPIO 4 GCLK (I2C CLK Pin)
import errno
from socket import error as socket_error

#Center 10: 9,10,11,12,13     16,17,18,19,20   #PVCB LED Number
#Center 10: C2-9, C2-10, C1-1, C1-2, C1-8      C2-6, C2-5, C2-4, C1-3, C1-9 #Led1642 Output Number (not pin number)
#aryLED_Brightness_Chip_n [ BASE 0, i.e. 0 = the first element in array]
aryLED_Brightness_Chip_1_Full_PWR = [100,100,100,100,100,100,100,100,100,100,100,100,100,100,100,0] #Overwritten during config.json load by iOEM_Calibrated_UV_LED_PWM
aryLED_Brightness_Chip_2_Full_PWR = [100,100,100,100,100,100,100,100,100,100,100,100,100,100,100,0] #Overwritten during config.json load by iOEM_Calibrated_UV_LED_PWM
aryLED_Brightness_Chip_1 = [100,60,60,60,100,100,100,100,10,10,100,90,90,90,100,0] #Overwritten during config.json load by iOEM_Calibrated_UV_LED_PWM
aryLED_Brightness_Chip_2 = [100,100,91,100,60,60,10,85,90,10,60,100,100,100,100,0] #Overwritten during config.json load by iOEM_Calibrated_UV_LED_PWM
aryLED_Brightness_Chip_1_White_LEDs_Only = [0,0,0,0,0,0,0,0,0,0,0,0,0,0,0,100] #OUT15 is LED, so last one.
aryLED_Brightness_Chip_2_White_LEDs_Only = [0,0,0,0,0,0,0,0,0,0,0,0,0,0,0,100] #OUT15 is LED, so last one.
iOEM_Calibrated_UV_LED_PWM = [100,100,100,100,100,100,100,90,10,60,60,60,10,90,90,10,60,60,60,10,90,100,100,100,100,100,100,100]; #Loaded to LED number 0-27 as found on PCB from Config.json
iPrint_UV_Time_Per_LED = [0,0,0,0,0,0,0,0,0,0,0,0,0,0,0,0,0,0,0,0,0,0,0,0,0,0,0,0]

fExposure_Power_mA_White_LED_Default = 14.0
fExposure_Power_mA_White_LED_Dimmed = 4.0

iLCD_Contrast = 23  #23 and 86 are peaks. See XLS Tab LCD_Contrast

#Init section for Pixel Over LEDs 
#aryLED_Brightness_Chip_1[ LED_4, LED_11, LED_12, LED_19, LED_26, na, LED_5, LED_6, LED_13, LED_20, LED_10, LED_28, LED_21, LED_14, LED_7, na]
#LED 0 == white LEDs to view LCD to get details on configutation as a UI
aryLED_To_LED1642_Output_Chip1 = [4,11,12,19,26,0,5,6,13,20,27,28,21,14,7,0] #This is a list 0-15 of Chip_Port with values of UV_LED_number i.e. Chip1_Port0 = UV_LED_4
aryLED_To_LED1642_Output_Chip2 = [25,24,23,22,18,17,16,15,8,9,10,1,2,3,0,0]
iPixel_Over_LED_Mode = 0; #0=Off : 1=Under_Pixel_Only_Full_Power : 2=Under_Px_Only_QACalibrated_Pwr : 3=Under_Px_Pnly_Equalized_Pwr : 4=Adjacent_Pix_Also_QA_Cal_Pwr : 5=Adjacent_Pix_Full_Power
iPixel_Over_LED_Power = 0; # 0=default PWM, 1=Pull 100% PWM, 2=averaged PWM

print_workers = []  #for thread control
powerValues = []    

#1/12/15 aryLED_Brightness_Chip_1 = [100,60,60,60,100,100,100,100,10,10,100,90,90,90,100,100]
#1/12/15 aryLED_Brightness_Chip_2 = [100,100,100,100,60,60,10,85,90,10,60,100,100,100,100,100]

#1/10/15 aryLED_Brightness_Chip_1 = [100,60,60,60,100,100,100,100,60,60,100,90,100,100,100,100]
#1/10/15 aryLED_Brightness_Chip_2 = [100,100,100,100,60,60,60,90,100,60,60,100,100,100,100,100]


#aryLED_Brightness_Chip_1 = [100,60,60,60,100,100,100,100,60,60,100,90,100,100,100,100]
#aryLED_Brightness_Chip_2 = [100,100,100,100,60,60,60,100,100,60,60,100,100,100,100,100]

#aryLED_Brightness_Chip_1 = [1,100,1,1,1,1,1,1,1,1,1,1,1,1,1,1]
#aryLED_Brightness_Chip_2 = [1,1,1,1,100,1,1,1,1,1,1,1,1,1,1,1]
#aryLED_Brightness_Chip_1 = [1,20,40,60,80,100,5,50,90,100,90,80,70,60,50,40]
#aryLED_Brightness_Chip_2 = [2,20,30,40,50,60,70,80,90,100,90,80,70,60,50,2]
#aryLED_Brightness_Chip_2 = [100,100,100,100,100,100,100,100,100,100,100,100,100,100,100,100]
strPad = "This string is to pad the file siz"
min_version = (2,6) #Force a minimum Python Version
if sys.version_info < min_version :
    print >> stderr, "must be run with at least Python 2.6 you should know better than that.  "
    sys.exit(1)
else:
    print("iBoxPrintmanager.py Loaded : python version: ",sys.version_info)
    sys.stdout.flush()

import serial #Digole from Paspbery Pi : From: http://www.seephar.com/2014/03/oled-display-for-raspberry-pi/

# START:  For StdIO Non Blocking Code
        # files monitored for input
read_list = [sys.stdin]
# select() should wait for this many seconds for input.
# A smaller number means more cpu usage, but a greater one
# means a more noticeable delay between input becoming
# available and the program starting to work on it.
timeout = 0.1 # seconds
last_work_time = time.time()
# END >> For StdIO Non Blocking Code

LCD_CS = 2 #or GPIO Bit bang from: http://www.raspberrypi.org/forums/viewtopic.php?f=32&t=25029
LCD_RST  = 3
LCD_A0 = 4
LCD_CLK = 27
LCD_SI = 17
#Logic
TRUE = 1
FALSE = 0
true = True
false = False

mnt_host = "192.168.1.122"
mnt_port = 12345

#Global Constants
bStepper_Drive_ULN2003 = TRUE
bUse_Display_NTSC = FALSE
bUse_Display_LCD = TRUE
bVideo_Output_NTSC = FALSE
bVideo_Output_Digole_128x64 = TRUE
imgTarget_Display_Size = 128, 64
strLayerImageDir = "/home/pi/projects/3D_Printer_Queue/"
strLayerImageSubDir = "_Rook" #"CagedBall" #"aluminum_beam_20mm_x20mm_x_600mm" #"HalfOpaque" #"aluminum_beam_20mm_x20mm_x_600mm" #"HalfOpaque" #"_Eiffel_Tower_100microns_42p9Tall" #"_Rabbit" #"_Rook" #"_Statue_Of_David_Head" #"_Rook" #"_Turbine_Dremel_Impeller" #"_Cellular_Lamp" #"_Birdcage_w_Bird" #"_Ring_Opensource_50micron" #"_Tank1" #"_Eiffel_Tower_100microns_42p9Tall" #"_Rabbit_50microns" #"_Ring_Link_50micron" #"_Pyramid5mm" #"_Rook" #"_Birdcage_w_Bird" #"_Rabbit" #"_Iron_Man_Ring1" #"_Thread_Draad_Both_60percent" #"_Keychain_Love" #"_Darth_Vader_med" #"_Lego_2x2" #"_Lego_Test1" #"_Lego_Ring" #"_Test_Calibration_Target_Form1" #"_Rook" #"_Manifold" #"_OpenBeam_Cap_BigBase" #"_Alum_Beam_20x20mm" #"_SphereGeo_W_Supports" #"_Iron_Man_Helmet2" #"_General_Grievous" #"_Tritium_Ring" #"_Cube_Hex_Supported_19mm" #"_SphereGeo_W_Supports" #"_Halo_Ring_100m" #"_Ring_95p_50micron" #"_Plug18mm" #"_Pyramid5mm" #"_Cube20mm" #"_OpenBeam_Cap" #"_Ring_110p_50micron" # #"_Ring_110p_50micron" #"_Ring_Square_Cutouts_RLCD" #"_RexSkull3_RLCD" #"_RexSkull2_RLCD" #"_RexSkull80p_RLCD" #"_RexSkull_RLCD" #"_Button_RLCD" #"_Cube_RLCD"
strLayerImageName_Base = "Rookv_fixed1" #"CagedSphere4" #"aluminumbeam600mm" #"HalfOpaque" #"aluminumbeam600mm" #"EiffelTower" #"bunny-flatfoot" #"Rookv_fixed1" #"david_remesh_01" #"Rookv_fixed1" #"Dremel_Impeller" #"cellularThing_optimizedForMakerbot" #"birdcage" #"open_hardware_ring" #"PzKpfw_VIB_Tiger_II" #"EiffelTower" #"bunny-flatfoot" #"linkBracelet" #"5mm_Calibration_Steps" #"Rookv_fixed1" #"birdcage" #"bunny-flatfoot" #"ironman_mask_ring_viv" #"DraadEnMoerVersie3_2_" #"keychain_love" #"darthVader_cleaned" #"customblock_r1_20131113-1047-a2c8l-0" #"L1" # #"L1" #"lego_ring3" #"calibrationtarget" #"Rookv_fixed1" #"manifold" #"TL625-000103-001_-_Feet_OpenBeam_1515" #"aluminumbeam600mm" #"sphere_plus_support" #"iron_mask_onepiece" #"GG_Printable" #"angel_ring-Actual_Cool_Ring" #"cube_small_supported" #"cube_small" #"sphere_plus_support" #"GD_Ring" #"test_plug" #"5mm_Calibration_Steps" #"20mm_Calibration_Box" #"TL625-000103-001_-_Feet_OpenBeam_1515" #"parametricRing_v.2.0" #"TL625-000103-001_-_Feet_OpenBeam_1515" #"parametricRing_v.2.0" #"dinifix" #"Dino_V1" #"Cutey-Rex_skins_OneHead" #"button_v1" #"Another_Hollow_Cube"
#//  SVG Print Vars  // 
strPrint_File_SVG = "" 
strPrint_File_Dir = "/home/pi/ibox/www/packages/"
strPtint_File_NoPath = "todo"
strPrint_File_SVG_noExt = "done"
strDirToMake = "done" #i.e. /home/pi/ibox/upload/data/your_file_name
strLayerImage_PNG_Folder_Append = "expanded/" #compressed/_svg/" #  4/3/15 was "data"

        
iNumber_Of_Layers = 301 #213 #50 #198 #301 #301 #549 #301 #170 #57 #160 #265 #506 #98 #427 #400 #429 #147 #72 #248 #301 #265 #198 #216 #237 #173 #130 #101 #113 #74 #281 #169 #301 #151 #68 #198 #231 #294 #261#187 67 #112 #55 #131 88 #248 #78 #131 #i.e. Last file number: #435 #Number of layers in current Print (Base 0, so 10 = 11 images 0-10) #150 #was 96; #i.e. 100 layers = 0-95


strLayerFileType = ".png"

#Printing States:
bPrinting_State_Printing = 0 # 0=Not printing 1=Printing
bPrinting_State_Printing_Last = 0;
bPrinting_State_Printing_Cancel = 0; #Set to 1 if you are printing and hit the print key again to CANCEL job
bPrinting_State_Driving_Stepper =0; #Print engine driving stepper, used to cancel mid stepper package execution in stepperStyep
bPrinting_State_Waiting_For_Platform_To_Reach_Bottom = 0; #platform moving down, waiting to print
bPrinting_Pause = 0
bEndstop_On_Z_Actuated = FALSE #Endstop = True means the Z has reached the lower range of its travel. The motor should not be actuaed further in this direction
iLayerNumber = 0
State_stepperEnable_Last = 0
iGlobal_Z_Position_Current = 0

start_time_Button_Down = 0.0
start_time_Button_Up = 0.0
start_time_Button_Print = 0.0

bBeep_After_Stepping = False
 
bLong_Press_Up = False
bLong_Press_Down = False 

#================  Printing Flags / Options / Settings  ==========================
bPrinting_Option_Direct_Print_With_Z_Homing = True #1=Zero Z before printing : 0=DO NOT Zero Z Before printing
#Z Travel Steps //  /1 = 1/8 :: /2 = 1/4 step. : /4 = 1/2 step :: /8 = 1:1 step
# at 1/8 Step moving 7.7mm UP takes 8 seconds and gives an accuracy of 64 steps / 50 microns.
#i.e. 1/2 is 4x faster than 1/8 and the step resolution drops from 50/64=[0.781 micron] to 50/(64/4)=[3.1 micron]
#i.e. at 1:1 step its 8x fater than 1/8th step and the resolution is 6.15 micron 50micron/(65/8) : Emperical: 3sec for 7mm
#Peel on Beta 2 is 6.5 and 7.5mm L / R so lets target 8mm = 80x 100micron layers = 80 * 164 = 13120 steps. At .006sec/step = 78 sec :( 8/31/14
#Reduced peel 9/1/14 : Removed 1x 5.6mm Peel_Z layer on each side. New L=2.8mm, new Right=1mm : 1.5mm = 2460steps == 14sec!! 3mm=5000steps @ 28sec

iGlobal_Z_Height_Peel_Stage_1 = 500 #microns Beta4=2500*(R=tight, L=one turn loosened) 4000 #3400 #2500 #300 : known Good #Fast part of peel
iGlobal_Z_Height_Peel_Stage_2 = 500 #microns Beta4=2500*(R=tight, L=one turn loosened) 4000 #3500 #500 #350 : known Good  #Slower part where the actual peel happens
iGlobal_Z_Layer_Thickness = 100 #microns Beta4=256 : 305 #257 #Beta3=256.83steps/100micron :1.5:1: Beta2=164steps/100micron on Beta2 : Alpha1=16 #Known Good:  for 50 micron : . 100 micron Layers
iOne_Layer_Of_Steps = 50  #iOne_Layer_Of_Steps = (iGlobal_Z_Layer_Thickness * iSteps_Per_100_Microns) / 100;
iSteps_Per_100_Microns = 256

iGlobal_Z_Layer_Micron_Thickness = 1 #was 100 for 100 microns/layer, but now we count in Microns and translate when we step using iSteps_Per_100_Microns #Must be set to calculate current position during Print
#1:1 50 microns at 6.18 microns/step = 8.09 steps : 65/8 ## for 75 microns 97 #was 65 for 50microns #was 129 #the Z Layer Thickness *see notes below on steps / mm
iGlobal_Z_Height_Retract = 30 #chaned to millimeters 3/14/2015 : 5511 #5500 #44000/8 #was 103332 #80mm on ORD Hadron Config_Alpha_A1 so 80/0.0007742=103,332 The highest Z to remove the finished part or perform maintence
iGlobal_Z_Height_Position_For_Print = 45 #Units mm #The endstop switch will stop it, have this be >> then Post Print Retract
iGlobal_Z_Height_Last_Build_Height = 0 #The last build completed, should be the current Z Height. If > 0 then there has been a Print attempt, thuus we can assume the unit was zeroed, thus the current heigt should be from True Z Zero.

########################################################
##### Red SubG seems to need at least a +1 on L4-N #### **UV LEDs need time to heat up and get to max current. First layer(s) exposure is lower because of this
#Printing Constants:####################################

iExposure_Time = 12.9 #12.9 #13 #known good for Alpha = 13 #12 #@140ma28led 13sec : @170mA Green 100micron = 18sec : #14sec@100micron : Units = Seconds i.e. 8.4sec : Known good for 50 microm=14sec :: 16 known good for 100 microns
fExposure_Time_Initial_Model_Layers = 13 #16 #9.5 #35 #known good for Alpha = 35 #@140ma 28led 30sec : 30-32 is strong : @170mA Green 100micron = 24sec : #Green KG 22 #15sec@100micron : 17 known good 50 micron :: 19 known good for 100 micron ::  First layer gets longer exposures *Some Resin printers have the bottom 3 layers getting 40% more UV time i.e. 5sec 1-3layers, and 3 next N
fExposure_Power_mA = 9.99 #UV-LED Drive Current in mA (*the higher you drive them the lifespan can/will be reduced)
########################################################
iModel_Layers_To_Overexpose = 3; #was 3

iGlobal_Z_Manual_Button_Speed_Up_Slow = 100 #150 #known good for Alpha = 30 #changed to iGlobal_Z_Layer_Thickness : was 30 #Increments per Push
iGlobal_Z_Manual_Button_Speed_Down_Slow = 100 #150 #known good for Alpha = 30 #changed to iGlobal_Z_Layer_Thickness : was 30 30 #Increments per Push
iGlobal_Z_Manual_Button_Speed_Up_Fast = 100000 #450 #known good for Alpha = 100 #Increments per Push
iGlobal_Z_Manual_Button_Speed_Down_Fast = 100000 #450 #known good for Alpha = 100 #Increments per Push
fDelay_Between_Rapid_Z_Botton_Events = 0.003 #known good for Alpha = 0.003 #in seconds. Delay between the Auto UP/Down button events, aka holding down button
#Acceleration Parameters
bStepper_Acceleration_Enabled = TRUE
bStepper_Deceleration_Enabled = TRUE
iGlobal_Z_Stepper_Acceleration_Percentage_Per_Step = 5 #Percentage of start-final speed to increase every step : i.e. 10 = 10% = 10 steps to get from initial delay to full_delay. 
iGlobal_Z_Stepper_Acceleration_Steps = 20
fGlobal_Stepper_Max_Pulse_Delay = 0.03
#Hardware mm/step emperical testing 5/27/14
#UP : 0.0007742mm/step or 0.774 microns/step
#Down : 0.00076mm/step or 0.76 microns *likely a testing error
#50 micron layer = 64.58279514337381
#100 micron layer = 129.16559028674762
#Could we run it at 1/4, 1/2 or 1:1 step? 
#1/8 = 129 steps / 100micron layer : 64.5 for 50micron
#1/4 = 64.58 steps / 100micron layer : 32 for 50 micron
#1/2 = 32.29 steps / 100micron layer : 16.145 for 50micron
#1:1 = 16.145steps / 100micron layer : 8 steps for 50 micron  
#Answer: Yes and it would be loads faster (800% at 1:1) and stronger for the PEEL process. 
#Cons: Resolution of layer thickness would not be acctrate, +/` 10%, but build height would still be fine because we know the distance. But it might be noiser.

#Units in seconds. Dataseet for 4988 states STEP Min HIGH Pulse = 1 uS or 0.000,001 sec : Same for LOW
#GRBL uses 30uS
#http://www.pololu.com/file/0J450/a4988_DMOS_microstepping_driver_with_translator.pdf
#Youtoube torque tests show 3mS to be max torque for 28BYJ-48 : https://www.youtube.com/watch?v=14jF8umwJLI&list=TLevyMuiCTzQvL_JuiRUI0BDY7kVrW0GuM
#Max torque is 300g-cm for unipolar, and 800g for bipolar at 5v (28BYJ-48) : https://www.youtube.com/watch?v=jHLyJbNgcDo&sns=em
#Testing of 28BYJ-48 on this site: http://www.jangeox.be/2013/10/stepper-motor-28byj-48_25.html
#  380 g-cm Full-Stepping at 3mS Delay aka 0.003
#  300 g-cm Half_Stepping at 3mS Delay
#  Max speed 1.2mS delay (0.0012) = 800pps = 5sec/rev
#  800g Full Step 5v in Bi-Polar Mode 3mS
fGlobal_Speed_Peel = 0.006 #0.012 most torque #0.001 #0.0011 #was for 1/8 th step 0.000060 #Fastest = 0.0000001, GRBL uses 0.00003
fGlobal_Speed_Down_Fast = 0.004 #0.002#0.001 ##0.0011 #was for 1:1 0.0007 #was 0.000001
fGlobal_Speed_Up_Fast   = 0.006 #0.002#0.001 ##0.0011 #was for 1:1 0.0008 #was 0.000001 for 1/8th step
fGlobal_Speed_Down_Slow = 0.01 #0.002#0.001 ##0.0011 #was for 1:1 0.0007 #was 0.000001
fGlobal_Speed_Up_Slow   = 0.01 #0.002#0.001 ##0.0011 #was for 1:1 0.0008 #was 0.000001 for 1/8th step
fGlobal_Speed_Down_Print = 0.004 #0.002#0.001 ##0.0011 #was for 1:1 0.0007 #was 0.000001
fGlobal_Speed_Up_Print   = 0.006 #0.002#0.001 ##0.0011 #was for 1:1 0.0008 #was 0.000001 for 1/8th step
#Test times:
#0.01sec has great torque on 28BYJ-48 5V at 140 mA (as set on driver)
#0.001 sec is fastest, but misses stepa on UP, need more testing
#0.01 sec is reliable on Down and medium torque *more tetsting needed 8/30/2014

#Calibration Vars
iGlobal_Calibration_Current_LED = 0

#Test Height / Step
#T#1 10000 steps @ 0.01sec DOWN ==> Result: 6.085mm / 10016 steps = 1646 steps / mm so 1step = 0.0006075mm == 0.6075microns = 100 micron layer = 164.6 steps
#T#2 Set layer thickness to 1000 then run 10x layers to make sure the start and end position is the same. So make final retract 1 : ==> Result: Start=58.68mm End=

strRoot_Path = "/home/pi/ibox/"
strSystem_File_Name = "mysystem.json"
strConfig_File_Name = "default.json"
strConfig_File_PathAndName = "/home/pi/ibox/"
strDashBeforeNumbers = "_" #was "_", but for easier integration with CreationWorkshop and how they number their files... Update: 4/3/15 F Creat Wkshop, _ is smarter
iJSON_System_File_Load_Counter = 0

#Foundation Layers: #4/19/15
iFoundation_Layer_Count = 0
iFoundation_Layer_Type = 0
fFoundation_Layer_Current = 0.0
fFoundation_Layer_Duration = 0.0
strFoundation_File_Name = ""

# Define the colors we will use in RGB format
BLACK = (  0,   0,   0)
WHITE = (255, 255, 255)
BLUE =  (  0,   0, 255)
GREEN = (  0, 255,   0)
RED =   (255,   0,   0)

ON = 0
OFF = 1
UP = 1
DOWN = 0
LED_ON = 0
LED_OFF = 1

UV_LED_OFF = 0
UV_LED_ON = 1

NPN_LED_ON = 1
NPN_LED_OFF = 0

PIEZO_ON = 1
PIEZO_OFF = 0

NPN_ON = 1
NPN_OFF = 0

ULN2003_ON = 1
ULN2003_OFF = 0

SPI_OFF = 0
SPI_ON = 1

bInvert_Stepper_Direction = TRUE
iGlobal_Currently_Stepping = FALSE

bSoundEnabled = TRUE

splash_screen_white_led_counter = 0

iContrast = 23

#Configure GPIO Pins

#ToDo List
# ILLUM_CTRL_GPIO3
#gpio_led_red_LCD_Illumination = 3

# BUZZER_PIEZO_GPIO15
gpio_sound_piezo_element = 15

#Indication LEDs RGB =======
#=======================
#====  Print RGB LEDs =====
#=====================
# B1_LED_RED_GPIO17           16 for SPI : 4 for pre 1p12p13 PCBs
# B1_LED_RED_GPIO17           20 for SPI : 4 for pre 1p12p23 PCBs
gpio_stepper_pin_led_red_B1 = 27# 2/1/15 PCB 1p12p30 : was 16#4##27 #4 #RGB 4,17,27
# B1_LED_GRN_GPIO4
gpio_stepper_pin_led_green_B1 = 20# 2/1/15 PCB 1p12p30 : was 27##17 #9/4/14==red
# B1_LED_BLU_GPIO27
gpio_stepper_pin_led_blue_B1 = 17##4 #27 #9/4/14==red

#Indication Single Color LEDs
# B2_LED_RED_GPIO22
#gpio_stepper_pin_led_red_B2 = 2 #22 #Changing to BUTTON_B_LED_BLU_GPIO2 for pCB Ver 1p5
BUTTON_B_LED_BLU = 2#18 #2 #v1p5p0
# B2_LED_GRN_GPIO18
#gpio_stepper_pin_led_green_B2 = 18 #Changing to : BUTTON_A_LED_GRN_GPIO18 for PCB Version 1p5
BUTTON_A_LED_GRN = 18#2 #18 #v1p5p0
# B2_LED_BLU_GPIO2
#gpio_stepper_pin_led_blue_B2 = 22 #2 #Changing to BUTTON_C_LED_RED_GPIO22 for PCB Ver 1p5
BUTTON_C_LED_RED = 16 # 2/1/15 depreciated, no longer an LED on the STOP pin button C22 #v1p5p0

#User Input : aka Buttons ==========
# BUTTON_A_GPIO10              13 for SPI : 10 for pre 1p12p13 PCBs
gpio_stepper_pin_button_down = 13 #10# Moving to GPIO 13 to free up SPI for LED driver : was10 #Move Z Down manually
# BUTTON_B_GPIO9              26 for SPI : 9 for pre 1p12p13 PCBs
gpio_stepper_pin_button_up = 26# 9 #Moving to GPIO26 to free up SDIO for ST LED1642 ::  ##Move Z Up Manually
# BUTTON_C_GPIO7              
gpio_stepper_pin_button_endstop = 7# 7 #Physical Microswitch indicating Z has hit its maximum travel.
bUse_Endstop = False #1=use endstop in printing and DOWN button, also in stepper Step. 0=Ignore. Created for Beta 4 which seems to have a bad GPIO7 :(
# BUTTON_D_GPIO11              
gpio_stepper_pin_button_print = 8 # switched because it is low at boot with UV LED : 11 #Start print job, if printing then Pause, hold down to Cancel print job

# UV_LED_CTRL_GPIO8       19 for SPI : 11 for pre 1p12p13 PCBs
gpio_stepper_pin_led_UV = 19#11 #Move to GPIO19 to free up SPI for ST LED1642 :: switched because 8 was HOT at boot : 8 #Activates UV LED. But not used anymore because UV_LED is controlled over SPI on the LED1642 chip


#///  DRV8834
# STEPPER_STEP_GPIO23
gpio_stepper_pin_step = 23 #one step tells the 4988 chip to increment 1x step.
# STEPPER_DIRECTION_GPIO24
gpio_stepper_pin_direction = 24 #0=down 1=up
# STEPPER_ENABLE_GPIO25
gpio_stepper_pin_enable = 25 #0= enable all stepper drivers 1=disable
#///  ULN2003
gpio_stepper_pin_1 = 23
gpio_stepper_pin_2 = 24
gpio_stepper_pin_3 = 5 #was 3, but needed I2C Port
gpio_stepper_pin_4 = 22

#SPI
bUse_SPI_LED1642_BitBang = True

gpio_spi_sdo = 9
gpio_spi_clk = 11
gpio_spi_le = 21
gpio_spi_sdi = 10
gpio_led1642_pwm = 20 #was 4 : Moved to 20 to ditch it temp, using WiringPi and its GPIO pcmd line program instead To Be Implemented

aryLED_State = [];

iPrint_Counter = -1
iPrint_Time = -1
iPrint_UV_Time = -1

iLoad_Counter_Python = -1
iPrints_Started = -1
iPrints_Finished = -1



# LCD_DATA_TX0_GPIO14 
#dead gpio_stepper_pin_button_pause = 11 #Pause print Job

class cPM(object):
    screen = None;
    port = serial.Serial("/dev/ttyAMA0", baudrate=9600, timeout=1.0) #known good, 11/20/14, trying to speed up digole image load.

    
    def __init__(self):
        "Ininitializes Print Manager"
        global bStepper_Drive_ULN2003
        print("...initializing Print Manager : Ver 1.4 : Updated 5/21/2015")
        #bStepper_Drive_ULN2003 = True moved to after first mySystem load, then set based on hardware version. i.e. 1.0 = False
        
        self.SPI_LED1642_Set_Clock_On_GPIO4(2400000)
        

                
        for s in range(50):
            aryLED_State.append(0); #set all LEDs to ON
        
        #Initialize GPIO : http://sourceforge.net/p/raspberry-gpio-python/wiki/Inputs/
        GPIO.setmode(GPIO.BCM)
        
        GPIO.setup(gpio_stepper_pin_enable, GPIO.OUT) #prevent crash in case the UNL2003 selection is misset.
        if(bStepper_Drive_ULN2003 == False):
            print(">>>   >>>>   >>> DRV8834");
            GPIO.setup(gpio_stepper_pin_step, GPIO.OUT) 
            GPIO.setup(gpio_stepper_pin_direction, GPIO.OUT)
            
        else: #ULN2003
            print(">>>>>>>>>>>>>>>>>>>>>>>>>>>>>>>>>> UNL2003 ::::");
            GPIO.setup(gpio_stepper_pin_1, GPIO.OUT)
            GPIO.setup(gpio_stepper_pin_2, GPIO.OUT)
            GPIO.setup(gpio_stepper_pin_3, GPIO.OUT)
            GPIO.setup(gpio_stepper_pin_4, GPIO.OUT)
        
        GPIO.setup(gpio_stepper_pin_led_red_B1, GPIO.OUT) 
        GPIO.setup(gpio_stepper_pin_led_green_B1, GPIO.OUT)
        GPIO.setup(gpio_stepper_pin_led_blue_B1, GPIO.OUT)
        GPIO.setup(BUTTON_B_LED_BLU, GPIO.OUT)
        #Test of outputing a frequency on GPIO 4 ro drive the dimming portion CLK of the ST LED1642 constant current led chip
        #GPIO.setmode(GPIO.BCM)
        #GPIO.setup(4,GPIO.ALT0)
        #GPIO.setclock(4,9500000) Result: This lib is missing key features of the standard GPIO lib, like callbacks and interrupts.
        
        GPIO.setup(BUTTON_A_LED_GRN, GPIO.OUT)
        #GPIO.setup(BUTTON_C_LED_RED, GPIO.OUT)
        
        #GPIO.setup(gpio_stepper_pin_led_UV, GPIO.OUT) #, pull_up_down=GPIO.PUD_DOWN) #, pull_up_down=GPIO.PUD_UP)
        
        GPIO.setup(gpio_stepper_pin_button_down, GPIO.IN)
        GPIO.setup(gpio_stepper_pin_button_up, GPIO.IN)
        GPIO.setup(gpio_stepper_pin_button_endstop, GPIO.IN) #, pull_up_down=GPIO.PUD_DOWN)
        GPIO.setup(gpio_stepper_pin_button_print, GPIO.IN, pull_up_down=GPIO.PUD_DOWN)
        
        #GPIO.setup(gpio_led_red_LCD_Illumination, GPIO.OUT)
        GPIO.setup(gpio_sound_piezo_element, GPIO.OUT)
        
        if bUse_SPI_LED1642_BitBang == True:
            
            GPIO.setup(gpio_spi_clk, GPIO.OUT)
            GPIO.setup(gpio_spi_sdo, GPIO.IN)
            GPIO.setup(gpio_spi_le, GPIO.OUT)
            GPIO.setup(gpio_led1642_pwm, GPIO.OUT)
            GPIO.setup(gpio_spi_sdi, GPIO.OUT)
            
            #Set SPI Defaults
            GPIO.output(gpio_spi_sdi, SPI_OFF);
            GPIO.output(gpio_spi_clk, SPI_OFF);
            GPIO.output(gpio_spi_le, SPI_OFF);
            GPIO.output(gpio_led1642_pwm, SPI_OFF);

        
        print("Running __init__");
        
        print("Set initial GPIO States");
        if(bStepper_Drive_ULN2003 == False):
            GPIO.output(gpio_stepper_pin_enable, 0)
        else: #ULN2003
            GPIO.output(gpio_stepper_pin_1, ULN2003_OFF)
            GPIO.output(gpio_stepper_pin_2, ULN2003_OFF)
            GPIO.output(gpio_stepper_pin_3, ULN2003_OFF)
            GPIO.output(gpio_stepper_pin_4, ULN2003_OFF)
            
        #GPIO.output(gpio_stepper_pin_led_UV, UV_LED_OFF);
        
        #LED Test Routine
        bLED_Test_Routine = True
        if bLED_Test_Routine == True:
            print("All LEDs ON")
            GPIO.output(gpio_stepper_pin_led_red_B1, LED_ON);
            GPIO.output(gpio_stepper_pin_led_green_B1, LED_ON);
            GPIO.output(gpio_stepper_pin_led_blue_B1, LED_ON);
            
            GPIO.output(BUTTON_B_LED_BLU, LED_ON);
            time.sleep(0.5);
            print("All LEDs OFF")
            GPIO.output(gpio_stepper_pin_led_red_B1, LED_OFF);
            GPIO.output(gpio_stepper_pin_led_green_B1, LED_OFF);
            GPIO.output(gpio_stepper_pin_led_blue_B1, LED_OFF);
            
            GPIO.output(BUTTON_B_LED_BLU, LED_OFF);
            GPIO.output(BUTTON_A_LED_GRN, LED_OFF);
            time.sleep(0.5);
            print("All Red and Button A")
            GPIO.output(gpio_stepper_pin_led_red_B1, LED_ON);
            GPIO.output(gpio_stepper_pin_led_green_B1, LED_OFF);
            GPIO.output(gpio_stepper_pin_led_blue_B1, LED_OFF);
            
            GPIO.output(BUTTON_B_LED_BLU, LED_OFF);
            GPIO.output(BUTTON_A_LED_GRN, LED_ON);
            time.sleep(0.5);
            print("All Green and Button B")
            GPIO.output(gpio_stepper_pin_led_red_B1, LED_OFF);
            GPIO.output(gpio_stepper_pin_led_green_B1, LED_ON);
            GPIO.output(gpio_stepper_pin_led_blue_B1, LED_OFF);
            
            GPIO.output(BUTTON_B_LED_BLU, LED_ON);
            GPIO.output(BUTTON_A_LED_GRN, LED_OFF);
            time.sleep(0.5);
            print("All Blue and Button A + B")
            GPIO.output(gpio_stepper_pin_led_red_B1, LED_OFF);
            GPIO.output(gpio_stepper_pin_led_green_B1, LED_OFF);
            GPIO.output(gpio_stepper_pin_led_blue_B1, LED_ON);
            
            GPIO.output(BUTTON_B_LED_BLU, LED_ON);
            GPIO.output(BUTTON_A_LED_GRN, LED_ON);
            time.sleep(1.0);
        
        GPIO.output(gpio_stepper_pin_led_red_B1, LED_OFF);
        GPIO.output(gpio_stepper_pin_led_green_B1, LED_OFF);
        GPIO.output(gpio_stepper_pin_led_blue_B1, LED_OFF);
        
        GPIO.output(BUTTON_B_LED_BLU, LED_OFF);
        GPIO.output(BUTTON_A_LED_GRN, LED_OFF);
        #GPIO.output(BUTTON_C_LED_RED, LED_ON);
        
        GPIO.output(gpio_sound_piezo_element, PIEZO_OFF);
        
        #Turn on internal RED Illum  //
        #GPIO.output(gpio_led_red_LCD_Illumination, NPN_LED_ON); #does not work, led likely in backwards ;)
        
        #Diasable Stepper Driver : Else they default to ON with current at 440mA instead of Idle at 240- (no wifi) to 280mA with WiFi
        self.stepperEnable(FALSE);
        

        #Turn off UV LEDs and turn on White LEDs so you can see the pretty Logo
        self.SPI_LED1642_Set_Brightness_PWM(101,aryLED_Brightness_Chip_1_White_LEDs_Only,aryLED_Brightness_Chip_2_White_LEDs_Only)
        #Adjust current of LEDs
        self.SPI_LED1642_Register_Configuration(fExposure_Power_mA_White_LED_Default); 
        #Turn on White LEDs
        self.controlLED_UV(UV_LED_ON);
        
        #File Info Defaults
        #imgLayerImage = pygame.image.load('Direct_Resin_Lithography_848x480.png').convert()
        #Example: /home/pi/projects/3D_Printer_Queue/Another_Hollow_Cube0000.png -...- 0096.png
        #Set Globally Now
        #strLayerImageDir = "/home/pi/projects/3D_Printer_Queue/";
        #strLayerImageName_Base = "Another_Hollow_Cube";
        iLayerNumber = 0; #Base 0
        strLayerFileType = ".png"
        
        #ONLY FOR NTSC
        if bUse_Display_NTSC:
            # Based on "Python GUI in Linux frame buffer"
            # http://www.karoltomala.com/blog/?p=679
            disp_no = os.getenv("DISPLAY")
            if disp_no:
                print ("I'm running under X display = {0}".format(disp_no));
            
            # Check which frame buffer drivers are available
            print("Processing FBCon Drivers");
            # Start with fbcon since directfb hangs with composite output
            drivers = ['fbcon', 'directfb', 'svgalib']
            print("Drivers: ", drivers);
            found = False
            for driver in drivers:
                # Make sure that SDL_VIDEODRIVER is set
                if not os.getenv('SDL_VIDEODRIVER'):
                    os.putenv('SDL_VIDEODRIVER', driver)
                try:
                    pygame.display.init()
                except pygame.error:
                    print ('Driver: {0} failed.'.format(driver));
                    continue
                found = True
                break
        
            if not found:
                raise Exception('No suitable video driver found!')
            
            size = (pygame.display.Info().current_w, pygame.display.Info().current_h)
            print ("Framebuffer size: %d x %d" % (size[0], size[1]));
            self.screen = pygame.display.set_mode(size, pygame.FULLSCREEN) #fails here sometimes and requires a reboot. A ctrrl+C clears this fail. Maybe a try; except;
            # Clear the screen to start
            self.screen.fill((0, 0, 0))        
            # Initialise font support
            print("init pygame font support")
            pygame.font.init()
            # Render the screen
            print("update display");
            pygame.display.update()
 
    def __del__(self):
        "Destructor to make sure print manager shuts down, etc."
        
    def get_ipaddress(self): #DOES NOT WORK
        "Returns the current IP address"
        #arg='ip route list'
        #p=subprocess.Popen(arg,shell=True,stdout=subprocess.PIPE)
        #data = p.communicate()
        #split_data = data[0].split()
        #ipaddr = split_data[split_data.index('src')+1]
        ipaddr = socket.gethostbyname(socket.gethostname());
        return ipaddr
        
    def get_local_ip_address(self,target):
        "Get the local paspberry Pi IP Address"
        #This one works!!!!!
        ipaddr = ''
        try:
            s = socket.socket(socket.AF_INET, socket.SOCK_DGRAM)
            s.connect((target, 8000))
            ipaddr = s.getsockname()[0]
            s.close()
        except:
            ipaddr = "error_2"
            pass
        
        return ipaddr
        
    def get_local_host_name(self) :
        "Get local host name"
        try:
            host_name = socket.gethostname()
        except:
            host_name = "error_3"
            pass
        
        print("host_name=",host_name);
        return host_name
        
    def get_local_wlan_ssid(self):
        "Get the current SSID"
        from subprocess import check_output
        ssid = "WiFi not found"
        
        try:
            #scanoutput = check_output(["iwlist", "ra0", "scan"])
            #from: http://askubuntu.com/questions/117065/how-do-i-find-out-the-name-of-the-ssid-im-connected-to-from-the-command-line
            #ssid = check_output(["iwgetid", "-r"])
            scanoutput = check_output(["iwgetid"])
            
            
            for line in scanoutput.split():
              line = line.decode("utf-8")
              if line[:5]  == "ESSID":
                ssid = line.split('"')[1]
        except:
            ssid = "error_4"
            pass
        
        print("ssid=",ssid)
        return ssid;
    
        
    def clear_screen(self):
        #self.screen.fill(WHITE); #Does not work??
        #pygame.clear(screen, backgroundSurface)
        size = (pygame.display.Info().current_w, pygame.display.Info().current_h)
        self.screen = pygame.display.set_mode(size, pygame.FULLSCREEN)
        self.screen.fill((0, 0, 0))
        # Update/Render the screen
        pygame.display.update()

        
    def changeLayer_NTSC(self, iLayerNumberCurrent):
        "Change the displayed image from splash screen or current Layer to indicated layer"
        #First clear the screen:
        self.clear_screen();
         
        iLayerNumber = iLayerNumberCurrent;
        strLayerNumber = str(iLayerNumber);
        #must pad to 0000, 0001, etc
        #print("len",len(strLayerNumber));
        #print('Image#', iLayerNumber);

        if(strDashBeforeNumbers == ""):
            if len(strLayerNumber) == 1:
                strLayerNumber = "000" + strLayerNumber;
                
            if len(strLayerNumber) == 2:
                strLayerNumber = "00" + strLayerNumber;
            
            if len(strLayerNumber) == 3:
                strLayerNumber = "0" + strLayerNumber;
        
        strLayerImageName = strLayerImageDir + "/" + strLayerImageName_Base + strDashBeforeNumbers + strLayerNumber + strLayerFileType;
        print("->" + strLayerImageName );
        imgLayerImage = pygame.image.load(strLayerImageName).convert()
        #write to screen
        self.screen.blit(imgLayerImage, (0,0));
        # Update/Render the screen
        pygame.display.update()

    def changeLayer_LCD(self, iLayerNumberCurrent):
        "Change the displayed image from splash screen or current Layer to indicated layer on LCD"
        global aryLED_State
        global bPrinting_State_Printing_Cancel
        global strFoundation_File_Name
        global iPixel_Over_LED_Mode
        global iPixel_Over_LED_Power

        #Clear Display 
        self.lcd_clear() #cPM.cPM
        
        iLayerNumber = iLayerNumberCurrent;
        strLayerNumber = str(iLayerNumber);
        #must pad to 0000, 0001, etc
        #print("len",len(strLayerNumber));
        #print('Image#', iLayerNumber);
        if(strDashBeforeNumbers == ""):
            if len(strLayerNumber) == 1:
                strLayerNumber = "000" + strLayerNumber;
                
            if len(strLayerNumber) == 2:
                strLayerNumber = "00" + strLayerNumber;
            
            if len(strLayerNumber) == 3:
                strLayerNumber = "0" + strLayerNumber;
        
        strLayerImageName = strLayerImageDir + "/" + strLayerImageName_Base + strDashBeforeNumbers + strLayerNumber + strLayerFileType;

        #:: Check for foundation Image  ///////////////////////////////////////////////
        if iLayerNumberCurrent < 0:
            print('changeLayer_LCD : Foundation Layer : changeLayer_LCD=[' + str(iLayerNumberCurrent) + '] : strFoundation_File_Name=[' + strFoundation_File_Name + ']')
            strLayerImageName = strFoundation_File_Name;


        print("->" + strLayerImageName + " => LCD");
        ###############################################
        ##### From 3 in Init  ###########################
        ###############################################
        boolImage_Loaded = False
        try:
            img = Image.open(strLayerImageName) #Using PIL (Python Image Library)
            boolImage_Loaded = True
            #Moved below so I can trap errors
        except: #Exception handling whilst opening files is always a great idea 
            boolImage_Loaded = False
            print("!!!!!!!!!!!!!!!!!!!!!!!!!!!!!!!!!!!!!!!!!!!!!!!!!!!!!!!!!!!!!!!!!!!!!!!!!!!!!!!!!!!!!!!!!!!!!!!!!!!!!!!!!!!!!!!!!!!!!!!!!!!!!!!!!!!")
            print("!!!!!!!!!!!           Unable to load image: ",strLayerImageName)
            print("!!!!!!!!!!!!!!!!!!!!!!!!!!!!!!!!!!!!!!!!!!!!!!!!!!!!!!!!!!!!!!!!!!!!!!!!!!!!!!!!!!!!!!!!!!!!!!!!!!!!!!!!!!!!!!!!!!!!!!!!!!!!!!!!!!!")
            #really should exit
            #The images may be in "processing" from Imagemagick's convert cmd line.
            #Maybe wait 10sec and try again?
            #turn off UV_LEDs
            #Disable UV LED
            self.controlLED_UV(UV_LED_OFF);
            time.sleep(10)
            iLayerNumberCurrent = iLayerNumberCurrent - 1 #rewind
            #comment this out for all pixel Clear
            bPrinting_State_Printing_Cancel = 1;
            return;
    
        if boolImage_Loaded == False:
            print(" Image did not load, exiting........")
            return;
            
        #print("The size of the Image is: ")
        #Debug i.e. PNG (128,64) RGBA 
        #print(img.format, img.size, img.mode)
        #if coming from Creation Workshop, the images will be 128x64 and scaled for the 40x19mm screen.
        #If coming from Slic3r, they will be scaled in SVG to some arbitrary pixel width/height that is less than the 40x19mm inputted into the printer>settings>build area config of Slic3r
        # Format to LCD size; currently 128x64
        if img.size != imgTarget_Display_Size: 
            print("Slic3r to iBox Nano : Image must be inserted in center of screen;  from " , img.size , " to " , imgTarget_Display_Size[0] , ", " , imgTarget_Display_Size[1])
            #try and do this from Imagemajic. Canvas needs to be set to 40x19, then you can scale and have it work.
            
        # Format to LCD size; currently 128x64
        if img.size != imgTarget_Display_Size: 
            print("Image must be resized from " , img.size , " to " , imgTarget_Display_Size[0] , ", " , imgTarget_Display_Size[1])
            basewidth = imgTarget_Display_Size[0]
            wpercent = (basewidth/float(img.size[0]))
            hsize = int((float(img.size[1])*float(wpercent)))
            print("Ratio from " , img.size , " to " , imgTarget_Display_Size[0] , ", " , imgTarget_Display_Size[1] , " is: " , wpercent , " so new Y is: " , hsize)
            #img = img.resize((basewidth,hsize), Image.ANTIALIAS)
            img = img.resize((basewidth,hsize))
            print("The NEW size of the Image is: ")
            print(img.format, img.size, img.mode)


        #Image needs to be flipped L to R and Top to Bottom : mage rotate will do this right? 180 deg
        #img = img.rotate(180)
        #Checked with an F and the image prints as expected on the build plate. However the image in the preview needs to be flipped top to bottom (Y axis)
        #Flip Top to Bottom:


        # use Image Convert to Type 1 (white or black) from: http://stackoverflow.com/questions/20541023/in-python-how-to-convert-array-of-bits-to-array-of-bytes
        bUse_ImgConvertType1Fcn = TRUE
        if bUse_ImgConvertType1Fcn:
            bits = list(img.convert("1").getdata())  #"list" converts image data to an ordinary sequence, in this case named "bits"
            #Other ways to access the image raw data:
            #pixels = img.load()
            
            #width, height = img.size
            #for x in range(width):
                #for y in range(height):
                    #cpixel = pixels[x, y]
                    #bw_value = int(round(sum(cpixel) / float(len(cpixel))))
                    #the above could probably be bw_value = sum(cpixel)/len(cpixel)
                    #all_pixels.append(bw_value)
                
            #im.getpixel(xy) ⇒ value or tuple ==> VERY SLOW
            #tobitmap #
            #im.tobitmap() ⇒ string
            #Returns the image converted to an X11 bitmap.
            #tostring #
            #im.tostring() ⇒ string
            #bits = list(img.convert("1").getdata())
            #Roll through array and change all 255s to 1s
            #for item in bits:
            #    if item == 255:
            #        bits[item] = 1 
            #    else:
            #        bits[item] = 0
            #b = raw_img_data
            # assuming that `bits` is your array of bits (0 or 1)
            # ordered from LSB to MSB in consecutive bytes they represent
            # e.g. bits = [0,0,0,0,0,0,0,1,1,1,1,1,1,1,1,1] will give you bytes = [128,255]
            bytesFromImgBits = [sum([byte[b] << b for b in range(0,8)]) for byte in zip(*(iter(bits),) * 8)]
            # warning! if len(bits) % 8 != 0, then these last bits will be lost
            # Send byte to LCD, rinse and repeat for 128x64=8192 bits or 1024 bytes.
            self.digole_drawBitmap_From_PIL_Image_Data(0,0,128,64,bytesFromImgBits); #cPM.cPM
            
            #Rotate Image
            #cPM.lcd_Tx_CMD("SD" + chr(2)) #rotate 0-3 = 0deg -- 270 deg ::==> Did not work

            
            #iPixel_Over_LED_Mode = 1; #0=Off : 1=Under_Pixel_Only_Full_Power : 2=Under_Px_Only_QACalibrated_Pwr : 3=Under_Px_Pnly_Equalized_Pwr : 4=Adjacent_Pix_Also_QA_Cal_Pwr : 5=Adjacent_Pix_Full_Power
            if iPixel_Over_LED_Mode == 0:
                #No fancy UAP (Under Active Pixel aka Pixel_Over_LED) modes here. Brightness of LEDs were set to defaults outside of this function. We need to set them here to turn OFF the white LEDs
                aryLED_Brightness_Chip_2[15] = 0   #Turn OFF White LEDs
                aryLED_Brightness_Chip_1[15] = 0   #Turn OFF White LEDs
                #The brightness function is called at every layer from : def print_all_layers(self): , but this function is called drom print_all_layers at each layer change.

            elif iPixel_Over_LED_Mode > 0:
                print("Using iPixel_Over_LED_Mode=",iPixel_Over_LED_Mode);
            
                #Set LED Brightness based on if there is open pixels above said LED.
                #This is to increase the Contrast between Opaque pixels and transparent pixels. 
                #Increasing contrast could have the following benefits:
                # 1. Unintended cure of resin due to some dose making it through the Opaque lcd pixels
                # 2. Sheeting and/or "slag" from unintended cure
                # 3. Increased LED power (mA->thus->uW/cm^2) which has the benefit of reduced cure time which has the benefit of reduced print time. i.e. 6mA takes 22sec/layer, and 12mA could take only 11sec/layer.
                # 4. Reduced current consumption which has many benefits including extended battery life, increased LED lifetime, reduced internal heating, reduced RPi current loading
                
                #Steps:
                #1. If any Pixel above LED_N is transparent, then the LED brightness should be > 0
                #2. If any Pixel above an adjacent LED to LED_N is transparent, then the LED_N brightness should be > 0 *Note: Adjavent is assuming 15 deg spread LEDs. At 30deg its two-adjacent. i.e. L-2 - L-1 L L+1 L+2
                #3. Pixels are "shades of grey" and thus do not have to be binary ON/OFF. i.e. if a nearby pixel needs some power the adjacent lEDs can be PWMed to 70%
                #Current brightness is stored in aryLED_Brightness_Chip_1 and aryLED_Brightness_Chip_2
                
                #Get list of Pixel Data:
                #1. http://stackoverflow.com/questions/1109422/getting-list-of-pixel-values-from-pil
                
                #Iterate though 128 pixels in chunks of 128/number of LEDs or more specifically width_in_pixels / led_count_width or 128/7
                #Iterate through 64 pixels in chinks of 64/number of LEDs or height_in_pixels / led_count_height or 64 / 4
                width_in_pixels, height_in_pixels = img.size
                iCurrent_LED_Square = 0
                led_count_height = 4;
                led_count_width = 7;
                iWidth_Step = int(width_in_pixels / led_count_width)
                iHeight_Step = int(height_in_pixels / led_count_height)
                print("iWidth_Step=",iWidth_Step," iHeight_Step=",iHeight_Step, " width_in_pixels=",width_in_pixels," height_in_pixels=",height_in_pixels)
                pixels = img.load()
                #aryLED_State[]; #28 elements, one per LED. Populated by default with 1s at Init
                PIXEL_ON = False
                    
                #print("START :: aryLED_Brightness_Chip_1:",aryLED_Brightness_Chip_1)
                #print("START :: aryLED_Brightness_Chip_2:",aryLED_Brightness_Chip_2)     
                
                for y in range(0, height_in_pixels, iHeight_Step): #Python3 range(begin, end, step) :: width-1 because 18.2 leaves a fraction that causes there to be 8 rows of leds instead of 7
                    for x in range(0, width_in_pixels-iWidth_Step, iWidth_Step):
                        iCurrent_LED_Square = iCurrent_LED_Square + 1
                        #This puts you in the CORNER pixel of each Square Area Over LED
                        #Now loop through this box looking for pixels. As sooon as you find one, mark it as LED ON and move to the next BOX
                        for xx in range(x,x+iWidth_Step):
                            for yy in range(y,y+iHeight_Step):
                                PIXEL_ON = False
                                if xx > 127:
                                    print("x: error---------------- xx=",xx," yy=",yy)
                                    xx = 127
                                    
                                if yy > 63:
                                    print("y : yyyyy error---------------- xx=",xx," yy=",yy)
                                    yy = 63
                                    
                                cpixel = pixels[xx, yy]
                                if isinstance( cpixel, int ):
                                    if cpixel == 0: #Single element aka True Binary black and white image
                                        MK=1;
                                    else:
                                        #print("[[",xx,",",yy,"]] - iCurrent_LED_Square=(",iCurrent_LED_Square,") :: cpixel=",cpixel)
                                        PIXEL_ON = True
                                        break
                                else:
                                    if cpixel[0] == 0: #Multiple elements, likely RGB
                                        MK=1;
                                    else:
                                        #print("[[",xx,",",yy,"]] - iCurrent_LED_Square=(",iCurrent_LED_Square,") :: cpixel=",cpixel)
                                        PIXEL_ON = True
                                        break

                                #if cpixel > 0:
                            if PIXEL_ON == True:
                                break

                                                          
                        if PIXEL_ON == True:
                            #print(">>>iCurrent_LED_Square=",iCurrent_LED_Square)
                            aryLED_State[iCurrent_LED_Square] = 1;
                            #print("LED[",iCurrent_LED_Square,"]=",PIXEL_ON)
                        else:
                            aryLED_State[iCurrent_LED_Square] = 0;
                        
                        #Reset:
                        PIXEL_ON = False
                        
                        #cpixel = pixels[x, y]
                        #bw_value = round(sum(cpixel) / float(len(cpixel)))
                        #the above could probably be bw_value = sum(cpixel)/len(cpixel)
                        #all_pixels.append(bw_value)
                        #print("[",x,",",y,"] - iCurrent_LED_Square=(",iCurrent_LED_Square,") :: cpixel=",cpixel," : PIXEL_ON=",PIXEL_ON)
            
                #Print out entire 28 LED array to console to make it Human Readable
                iCurrent_LED_Square = 0;
                for y in range(0, height_in_pixels, iHeight_Step): 
                    print(" : "); 
                    for x in range(0, width_in_pixels-iWidth_Step, iWidth_Step): 
                        iCurrent_LED_Square = iCurrent_LED_Square + 1;
                        print(" : " , aryLED_State[iCurrent_LED_Square], end="")
                    print(" : ");  

                iLED_ON_Counter = 0;
                if iPixel_Over_LED_Mode == 3: #5/2/2015
                    #Is only one LED on?
                    iCurrent_LED_Square = 0;
                    for y in range(0, height_in_pixels, iHeight_Step): 
                        for x in range(0, width_in_pixels-iWidth_Step, iWidth_Step): 
                            iCurrent_LED_Square = iCurrent_LED_Square + 1;
                            if aryLED_State[iCurrent_LED_Square] == 1:
                              iLED_ON_Counter = iLED_ON_Counter + 1;
                    print('UAP-3 : iLED_ON_Counter=' + str(iLED_ON_Counter))

                if iPixel_Over_LED_Mode == 3 and iLED_ON_Counter < 3: #5/2/2015
                    print("Min_LED_Count LED Version:==================Basically dont ever use 1 led for an item with a pointy top. And no diagonal LEDs. iLED_ON_Counter=" + str(iLED_ON_Counter))


                    aryLED_State_TMP = aryLED_State[:]; #Make a copy
                    #No LED Left Behond, never use just one LED
                    for L in range(1,29):
                        C = L - 1; #int((L - 1)/7) #For determining of the leds are on the same row you need to int((LED_Number - 1) / 7)
                        #print("L=",L)
                        if aryLED_State[L] == 1: #only enable adjacenet LEDs for active LEDs
                            if int((C+1)/7) == int((C)/7): #+1
                                aryLED_State_TMP[L+1] = 1;
                                #print(L," : #+1 : aryLED_State_TMP[",L+1,"]=",aryLED_State_TMP[L+1])
                            if int((C-1)/7) == int((C)/7): #-1  
                                aryLED_State_TMP[L-1] = 1;  
                                #print(L," : #-1 : aryLED_State_TMP[",L-1,"]=",aryLED_State_TMP[L-1])
                            if L+7 <= 28: #In bounds ABOVE
                                #if int((7+C+1)/7) == int((7+C)/7): #+One Row +1
                                #    aryLED_State_TMP[L+7+1] = 1;
                                #    #print(L," : #+One Row +1 : aryLED_State_TMP[",L+7+1,"]=",aryLED_State_TMP[L+7+1])
                                #if int((7+C-1)/7) == int((7+C)/7): #+One Row -1  
                                #    aryLED_State_TMP[L+7-1] = 1;   
                                #    #print(L," : #+One Row -1 : aryLED_State_TMP[",L+7-1,"]=",aryLED_State_TMP[L+7-1])
                                aryLED_State_TMP[L+7] = 1; #+One Row +0 aka Directly Above
                            if L-7 >= 1: #In bounds BELOW
                                #if int((C+1-7)/7) == int((C-7)/7): #-One Row +1
                                #    aryLED_State_TMP[L-7+1] = 1;
                                #if int((C-1-7)/7) == int((C-7)/7): #-One Row -1  
                                #    aryLED_State_TMP[L-7-1] = 1;      
                                aryLED_State_TMP[L-7] = 1; #+One Row +0 aka Directly Below
                                    
                    
                    
                    iCurrent_LED_Square = 0;
                    for y in range(0, height_in_pixels, iHeight_Step): 
                        print(" : ");
                        for x in range(0, width_in_pixels-iWidth_Step, iWidth_Step):
                            iCurrent_LED_Square = iCurrent_LED_Square + 1;
                            print(" : " , aryLED_State_TMP[iCurrent_LED_Square], end="")
                        print(" : "); 
                        
                    aryLED_State = aryLED_State_TMP[:]; #Copy back to original Array : Make a copy
                
                if iPixel_Over_LED_Mode == 4 or iPixel_Over_LED_Mode == 5:
                    print("Adjacent LED Version:===================")
                    aryLED_State_TMP = aryLED_State[:]; #Make a copy
                    #Find Adjacent LEDs
                    for L in range(1,29):
                        C = L - 1; #int((L - 1)/7) #For determining of the leds are on the same row you need to int((LED_Number - 1) / 7)
                        #print("L=",L)
                        if aryLED_State[L] == 1: #only enable adjacenet LEDs for active LEDs
                            if int((C+1)/7) == int((C)/7): #+1
                                aryLED_State_TMP[L+1] = 1;
                                #print(L," : #+1 : aryLED_State_TMP[",L+1,"]=",aryLED_State_TMP[L+1])
                            if int((C-1)/7) == int((C)/7): #-1  
                                aryLED_State_TMP[L-1] = 1;  
                                #print(L," : #-1 : aryLED_State_TMP[",L-1,"]=",aryLED_State_TMP[L-1])
                            if L+7 <= 28: #In bounds ABOVE
                                if int((7+C+1)/7) == int((7+C)/7): #+One Row +1
                                    aryLED_State_TMP[L+7+1] = 1;
                                    #print(L," : #+One Row +1 : aryLED_State_TMP[",L+7+1,"]=",aryLED_State_TMP[L+7+1])
                                if int((7+C-1)/7) == int((7+C)/7): #+One Row -1  
                                    aryLED_State_TMP[L+7-1] = 1;   
                                    #print(L," : #+One Row -1 : aryLED_State_TMP[",L+7-1,"]=",aryLED_State_TMP[L+7-1])
                                aryLED_State_TMP[L+7] = 1; #+One Row +0 aka Directly Above
                            if L-7 >= 1: #In bounds BELOW
                                if int((C+1-7)/7) == int((C-7)/7): #-One Row +1
                                    aryLED_State_TMP[L-7+1] = 1;
                                if int((C-1-7)/7) == int((C-7)/7): #-One Row -1  
                                    aryLED_State_TMP[L-7-1] = 1;      
                                aryLED_State_TMP[L-7] = 1; #+One Row +0 aka Directly Above
                                    
                    
                    
                    iCurrent_LED_Square = 0;
                    for y in range(0, height_in_pixels, iHeight_Step): 
                        print(" : ");
                        for x in range(0, width_in_pixels-iWidth_Step, iWidth_Step):
                            iCurrent_LED_Square = iCurrent_LED_Square + 1;
                            print(" : " , aryLED_State_TMP[iCurrent_LED_Square], end="")
                        print(" : "); 
                        
                    aryLED_State = aryLED_State_TMP[:]; #Copy back to original Array : Make a copy
                    
                #Turn off LEDs that are NOT NEEDED: This will increase contrast and decrease inadvertant cure.
                #Notes: The screen is inverted. 
                #LED1 is Front-Right and 28 is Rear-Left
                #USE def SPI_LED1642_Set_Brightness_PWM(self, iBrightness_Percentage, aryLED_Brightness_Chip_1, aryLED_Brightness_Chip_2):
                #or ON/OFF, like "77" but the code is not written.
                #Pythin Lists: http://effbot.org/zone/python-list.htm
                #Although I refer tho them as Arrays in Python these are Lists. To make a copy of a list you need to use A = B[:], NOT A = B. If you use A = B then both lists will be modified if either is modified. 
                aryLED_Brightness_Chip_1_TMP = aryLED_Brightness_Chip_1[:];
                aryLED_Brightness_Chip_2_TMP = aryLED_Brightness_Chip_2[:];
                
                #aryLED_Brightness_Chip_1[ LED_4, LED_11, LED_12, LED_19, LED_26, na, LED_5, LED_6, LED_13, LED_20, LED_10, LED_28, LED_21, LED_14, LED_7, na]
                #LED 0 == white LEDs to view LCD to get details on configutation as a UI
                # Moved to begining of file as static 
                ##aryLED_To_LED1642_Output_Chip1 = [4,11,12,19,26,0,5,6,13,20,27,28,21,14,7,0] #This is a list 0-15 of Chip_Port with values of UV_LED_number i.e. Chip1_Port0 = UV_LED_4
                ##aryLED_To_LED1642_Output_Chip2 = [25,24,23,22,18,17,16,15,8,9,10,1,2,3,0,0]

                #Loop through Chip ports, turning the PWM to ZERO for the un-used LEDs, and setting the PWM for the used LEDs from the Manufacturing_and_Test_Array aryLED_Brightness_Chip_1
                for i in range(15): #Loop through LED1642 Chip Ports
                    if aryLED_State[aryLED_To_LED1642_Output_Chip1[i]] == 1:# ON
                        if iPixel_Over_LED_Power == 0: #NEW 5/11/15 : // 0=default PWM, 1=Full 100% PWM, 2=averaged PW -> OLD >> #0=Off : 1=Under_Pixel_Only_Full_Power : 2=Under_Px_Only_QACalibrated_Pwr : 3=Under_Px_Pnly_Equalized_Pwr : 4=Adjacent_Pix_Also_QA_Cal_Pwr
                            aryLED_Brightness_Chip_1_TMP[i] = aryLED_Brightness_Chip_1[i]
                        elif iPixel_Over_LED_Power == 1:
                            aryLED_Brightness_Chip_1_TMP[i] = 100;
                        elif iPixel_Over_LED_Power == 2:
                            #Averaged PWM
                            iConcatonated_Lists = aryLED_Brightness_Chip_1 + aryLED_Brightness_Chip_2
                            iAveragedPWM = np.mean(iConcatonated_Lists)
                            aryLED_Brightness_Chip_1_TMP[i] = iAveragedPWM
                            
                        #print("aryLED_Brightness_Chip_1_TMP[",i,"] = [",aryLED_Brightness_Chip_1_TMP[i],"]")
                        #print("aryLED_Brightness_Chip_1[",i,"] = [",aryLED_Brightness_Chip_1[i],"]")
                        ##print("====>aryLED_State[aryLED_To_LED1642_Output_Chip1[",i,"]]=[",aryLED_State[aryLED_To_LED1642_Output_Chip1[i]],"] aryLED_To_LED1642_Output_Chip1[i]=",aryLED_To_LED1642_Output_Chip1[i])

                    else: # OFF
                        aryLED_Brightness_Chip_1_TMP[i] = 0; #1=debug, should be 0
                        
                    #LED1642_Chip_2
                    if aryLED_State[aryLED_To_LED1642_Output_Chip2[i]] == 1:# ON
                        if iPixel_Over_LED_Power == 0: #NEW 5/11/15 : // 0=default PWM, 1=Full 100% PWM, 2=averaged PW -> OLD >>#0=Off : 1=Under_Pixel_Only_Full_Power : 2=Under_Px_Only_QACalibrated_Pwr : 3=Under_Px_Pnly_Equalized_Pwr : 4=Adjacent_Pix_Also_QA_Cal_Pwr
                            aryLED_Brightness_Chip_2_TMP[i] = aryLED_Brightness_Chip_2[i]
                        elif iPixel_Over_LED_Power == 1:
                            aryLED_Brightness_Chip_2_TMP[i] = 100;
                        elif iPixel_Over_LED_Power == 2:
                            #Averaged PWM
                            iConcatonated_Lists = aryLED_Brightness_Chip_1 + aryLED_Brightness_Chip_2
                            iAveragedPWM = np.mean(iConcatonated_Lists)
                            aryLED_Brightness_Chip_2_TMP[i] = iAveragedPWM
                        
                        #print("aryLED_Brightness_Chip_2_TMP[",i,"] = [",aryLED_Brightness_Chip_2_TMP[i],"]")
                        #print("aryLED_Brightness_Chip_2[",i,"] = [",aryLED_Brightness_Chip_2[i],"]")
                        ##print("====>aryLED_State[aryLED_To_LED1642_Output_Chip2[",i,"]]=[",aryLED_State[aryLED_To_LED1642_Output_Chip2[i]],"] aryLED_To_LED1642_Output_Chip2[i]=",aryLED_To_LED1642_Output_Chip2[i])

                    else: # OFF
                        aryLED_Brightness_Chip_2_TMP[i] = 0; #2=debug, should be 0
                        
                    #print("aryLED_State[aryLED_To_LED1642_Output_Chip1[",i,"]]=[",aryLED_State[aryLED_To_LED1642_Output_Chip1[i]],"] aryLED_To_LED1642_Output_Chip1[i]=",aryLED_To_LED1642_Output_Chip1[i])
                    #print("aryLED_State[aryLED_To_LED1642_Output_Chip2[",i,"]]=[",aryLED_State[aryLED_To_LED1642_Output_Chip2[i]],"] aryLED_To_LED1642_Output_Chip2[i]=",aryLED_To_LED1642_Output_Chip2[i])
                        
                #print("END :: aryLED_Brightness_Chip_1:",aryLED_Brightness_Chip_1)
                #print("END :: aryLED_Brightness_Chip_2:",aryLED_Brightness_Chip_2)   
                #Turn OFF white LEDs
                aryLED_Brightness_Chip_2_TMP[15] = 0   
                aryLED_Brightness_Chip_1_TMP[15] = 0     
                
                self.SPI_LED1642_Set_Brightness_PWM(101,aryLED_Brightness_Chip_1_TMP,aryLED_Brightness_Chip_2_TMP)
                        
    def changeLayer(self,iLayerNumberCurrent):
        "Change the Image on the Layer"
        start_time = time.time()
        if bUse_Display_NTSC:
            self.changeLayer_NTSC(iLayerNumberCurrent);
            
        if bUse_Display_LCD:
            self.changeLayer_LCD(iLayerNumberCurrent); #cPM.cPM
        
        finish_time = time.time()
        print("changeLayer: IMG Load Time = %.3f" % (finish_time - start_time))
        
    def drawGraticule(self):
        "Draws a grid for alignment and test"
        # the grid should be evenly spaced on X and Y to determine of there is distortion on X-Y
        borderColor = (255, 255, 255)
        lineColor = (64, 64, 64)
        subDividerColor = (128, 128, 128)
        # Draw a rectangle with a 4px boarder
        pygame.draw.rect(self.screen, borderColor, (10,10,848-10,470), 4)#(10,10,630,470), 4)
        # Horizontal lines (40 pixels apart)
        for i in range(0, 12):
            y = 10+(i*40)
            pygame.draw.line(self.screen, lineColor, (10, y), (848-10, y))
        # Vertical lines (50 pixels apart)
        for i in range(0, 12):
            x = 10+(i*40*1.7647) #1.7647 is to account for 480x272 ratio
            pygame.draw.line(self.screen, lineColor, (x, 10), (x, 848-10))
        # Vertical sub-divisions (8 pixels apart)
        #for i in range(1, 40):
        #    y = 30+i*8
        #    pygame.draw.line(self.screen, subDividerColor, (258, y), (262, y))
        # Horizontal sub-divisions (10 pixels apart)
        #for i in range(1, 50):
        #    x = 10+i*10
        #    pygame.draw.line(self.screen, subDividerColor, (x, 188), (x, 192))
 
    def test(self):
        "Test method to make sure the display is configured correctly"
        adcColor = (255, 255, 0)  # Yellow
        self.drawGraticule()
        # Render the Adafruit logo at 10,360
        ###logo = pygame.image.load('Direct_Resin_Lithography_848x480.png').convert()
        logo = pygame.image.load('RPi_Contrast_848x480.jpg').convert()
        #orig TRC self.screen.blit(logo, (10, 335))
        #self.screen.blit(logo, ((848-480)/2,(480-272)/2))
        #self.screen.blit(logo, ((848)/2,(480)/2))
        self.screen.blit(logo, (0,0))
        # Get a font and use it render some text on a Surface.
        print ('IP-address: '+self.get_ipaddress())
        #strIpAddress = self.get_ipaddress()
        #strIpAddress = "IP Address Here";
        font = pygame.font.Font(None, 32)
        #Rennder in 255,255,255   # White text
        #text_surface = font.render('pyScope (%s)' % "0.1",True, (255, 255, 255))
        text_surface = font.render('%s' %self.get_ipaddress(),True, (255, 255, 255))
        # Blit the text at 10, 0
        self.screen.blit(text_surface, (20, 490-30)) 
        # Render some text with a background color # Black text with yellow BG
        text_surface = font.render('Channel 0',True, (0, 0, 0), (255, 255, 0)) 
        # Blit the text
        #self.screen.blit(text_surface, (120, 50))
        # Update the display
        pygame.display.update()
        # Random adc data
        yLast = 260
        #for x in range(10, 509):
        #    y = random.randrange(30, 350, 2) # Even number from 30 to 350
        #    pygame.draw.line(self.screen, adcColor, (x, yLast), (x+1, y))
        #    yLast = y
        #    pygame.display.update()
      
    
    def load_splash_screen(self):
        "Load the Splash / Landing Screen"
        global splash_screen_white_led_counter
        print("Load Splash Screen");
        self.lcd_clear() #cPM.cPM
        

        
        print("Setup LED1642 Brightness to defaults : from=>load_splash_screen")
        #You are about to show the user something on the LCD, so turn the UV power OFF, that will leave the White LEDs ON.
        


        #Set LCD Contrast from profile settings
        #self.lcd_Tx_CMD("CT" + chr(iLCD_Contrast))
        self.lcd_Tx_CMD("CT" + chr(23)) #Harshas recomendation

        
        
        strIPAddress = self.get_local_ip_address('10.0.1.1')
        strHostname = self.get_local_host_name()#cPM.cPM - 1/18/15
        strSSID = self.get_local_wlan_ssid()#cPM.cPM

        #Trap error_2 and error_4 and replace with No WPS AP and x.x.x.x for IP Address SSID field = 15 charcters, maybe 16
        if strIPAddress == 'error_2' or strIPAddress == 'error_4':
            strIPAddress = 'x.x.x.x'
        if strSSID == 'error_2' or strSSID == 'error_4':
            strSSID = 'Not Associated'
        print("Raspberry Pi - Local IP Address:",strIPAddress, " Hostname:", strHostname, " SSID:", strSSID)
        
        self.lcd_Tx_CMD("DM^") #cPM.cPM#Display Mode for on coming command, the available values for B are: “!””~” not, “|” or, “^” xor, “&” and, this means the next drawing pixel will logic operation with pixel already on screen.
        
        #Draw filled rectangle BLACK
        self.lcd_Tx_CMD("FR" + chr(0) + chr(0) + chr(1300) + chr(1300)) ##cPM.cPM
        
        #Try rotating Text 
        self.lcd_Tx_CMD("SD" + chr(2)) #rotate 0-3 = 0deg -- 270 deg#cPM.cPM
        
        self.lcd_Tx_CMD("SC" + chr(1)) # Set color 0=black and 1=white#cPM.cPM
        
        #exampleMessage = "" + strIPAddress
        #Set text in middle of screen
        #cPM.lcd_Tx_CMD("TP")
        #cPM.lcd_Tx_Byte(64)
        #cPM.lcd_Tx_Byte(32)
        ##self.lcd_Tx_CMD("TT" + "IP Address:" + chr(0))#cPM.cPM
        ##self.lcd_Tx_CMD("TP" + chr(0) + chr(1))#cPM.cPM
        ##self.lcd_Tx_CMD("TT" + strIPAddress + chr(0))#cPM.cPM
        self.lcd_Tx_CMD("TT" + strIPAddress + chr(0))#cPM.cPM
        self.lcd_Tx_CMD("TP" + chr(0) + chr(1))
        #strIP_Address = self.get_local_ip_address('10.0.1.1')

   
        #TTBB = Set text postiotn "TP" where BB are X and Y
        ##self.lcd_Tx_CMD("TP" + chr(0) + chr(2))#cPM.cPM
        ##self.lcd_Tx_CMD("TT" + "Printer Name:" + chr(0))#cPM.cPM
        ##self.lcd_Tx_CMD("TP" + chr(0) + chr(3))#cPM.cPM
        ##self.lcd_Tx_CMD("TT" + strHostname + chr(0))#cPM.cPM
        self.lcd_Tx_CMD("TTName:" + chr(0))
        self.lcd_Tx_CMD("TP" + chr(0) + chr(2))
        self.lcd_Tx_CMD("TT" + strHostname + chr(0))
        self.lcd_Tx_CMD("TP" + chr(0) + chr(3))
        #self.lcd_Tx_CMD("TP" + chr(0) + chr(4))#cPM.cPM
        self.lcd_Tx_CMD("TTSSID:" + chr(0))#cPM.cPM
        self.lcd_Tx_CMD("TP" + chr(0) + chr(4))

        self.lcd_Tx_CMD("TT" + strSSID + chr(0))
        #Run UV LEDs for 5 sec
        
        if splash_screen_white_led_counter == 0:
            splash_screen_white_led_counter = 8 #2 sec decrements. i.e. 10 = 20sec
            self.SPI_LED1642_Register_Configuration(fExposure_Power_mA_White_LED_Default);
            self.SPI_LED1642_Set_Brightness_PWM(101,aryLED_Brightness_Chip_1_White_LEDs_Only,aryLED_Brightness_Chip_2_White_LEDs_Only)
            self.controlLED_UV(UV_LED_ON);
        #self.SPI_LED1642_Set_Brightness_PWM(101,aryLED_Brightness_Chip_1,aryLED_Brightness_Chip_2);
        #time.sleep(10.555555555)
        #self.SPI_LED1642_Register_Configuration(fExposure_Power_mA_White_LED_Dimmed);
        #self.SPI_LED1642_Set_Brightness_PWM(101,aryLED_Brightness_Chip_1_White_LEDs_Only,aryLED_Brightness_Chip_2_White_LEDs_Only)
        #Turn off after X seconds from main loop, or at first button press
        #self.controlLED_UV(UV_LED_OFF);

    def stepperStep(self,iSteps,bDirection,fPulse_Width_Z):
        "Execute GPIOs to move Stepper Motors Z steps in a direction"
        iSteps = int(iSteps)
        global iGlobal_Z_Position_Current #0 = first layer Z 
        global iGlobal_Z_Layer_Micron_Thickness #100 / 75 / 50 micron
        global bPrinting_State_Printing 
        global bPrinting_State_Printing_Cancel 
        global bPrinting_State_Driving_Stepper
        
        global bStepper_Acceleration_Enabled
        global bStepper_Deceleration_Enabled
        global iGlobal_Z_Stepper_Acceleration_Percentage_Per_Step
        global iGlobal_Z_Stepper_Acceleration_Steps
        global fGlobal_Stepper_Max_Pulse_Delay
        global iGlobal_Currently_Stepping
        global bUse_Endstop
        global bBeep_After_Stepping
        global bStepper_Drive_ULN2003 
        
        iCntLED = 0;
        bLED_State = 0;

        fPulse_Width_Z_Adj_For_Acceleration = fPulse_Width_Z
        
        start_time_Stepper = time.time() 
        
        if iGlobal_Currently_Stepping == TRUE:
            print("!!!!Currently stepping, so HALT Movement!!!!!!");
            self.stepperEnable(FALSE);
            iGlobal_Currently_Stepping = FALSE;
            #time.sleep(0.1); #debounce ==> remed because it might have been casing a RACE condition, making it more likely to have two instances of stepperStep running at the same time
            return;
        
        #print("Entered StepperStepping : Start")
        iGlobal_Currently_Stepping = TRUE; 
        
        if bStepper_Acceleration_Enabled == 'true' or bStepper_Deceleration_Enabled == 'true':
            #Calculations that need to be completed only once for Acceleration/Deceleration
            #fAcceleration_Constant_Local = (fPulse_Width_Z * (100.0 / iGlobal_Z_Stepper_Acceleration_Percentage_Per_Step));
            #Initial-final / Steps
            fAcceleration_Constant_Local = (fGlobal_Stepper_Max_Pulse_Delay - fPulse_Width_Z) / (100.0 / iGlobal_Z_Stepper_Acceleration_Percentage_Per_Step);
            fAccelerated_Delay = fGlobal_Stepper_Max_Pulse_Delay;
            fPulse_Width_Z_Adj_For_Acceleration = fAccelerated_Delay;
            #print(">> accel >>>>>> fAcceleration_Constant_Local:",fAcceleration_Constant_Local);
        #Enable Stepper Driver  
        self.stepperEnable(TRUE);
        #Invert UP and Down
        bDirection_Local = bDirection
        #if bInvert_Stepper_Direction == TRUE:
        #    if bDirection == UP:
        #        bDirection_Local = DOWN
        #    else:
        #        bDirection_Local = UP
        #Set Direction
        if(bStepper_Drive_ULN2003 == False):
            GPIO.output(gpio_stepper_pin_direction, bDirection_Local);
        if bDirection_Local == UP:
            print("Steps:", iSteps, "Direction:UP", bDirection_Local, "fPulse_Width_Z:",fPulse_Width_Z,"PositionZ:",iGlobal_Z_Position_Current," Height:%.2f" %  ((iGlobal_Z_Position_Current / iSteps_Per_100_Microns) / 100.0));
        if bDirection_Local == DOWN:
            print("Steps:", iSteps, "Direction:DOWN", bDirection_Local, "fPulse_Width_Z:",fPulse_Width_Z,"PositionZ:",iGlobal_Z_Position_Current," Height:%.2f" %  ((iGlobal_Z_Position_Current / iSteps_Per_100_Microns) / 100.0));
        
        #Measure entire process time:
        start_time_EP = time.time()
        
        if(True): # || bStepper_Drive_ULN2003 == False
            for i in range(iSteps):
                #Check for endstop, if endstop then exit and alery user  
                if bDirection_Local == DOWN : # DOWN
                    if False and GPIO.input(gpio_stepper_pin_button_endstop) == 1 and bUse_Endstop == 'true':
                    #if bEndstop_On_Z_Actuated == TRUE:
                        print("you should never see this : disabled, handle this in buttonEventHandler_endstop_rising_or_falling");
                        print("!!!!!!!!!Endstop reached : Step Command Terminated on Step# ",i," at PositionZ:",iGlobal_Z_Position_Current," Height:%.2f" %  ((iGlobal_Z_Position_Current / iSteps_Per_100_Microns) / 100.0),"!!!!!!!!!!!!!!!!");
                        i = iSteps;
                        #Disable Stepper driver
                        self.stepperEnable(FALSE);
                        iGlobal_Currently_Stepping = FALSE;
                        self.led_button_A_green(LED_OFF);
                        self.led_button_B_blue(LED_OFF);
                        return;
                    iGlobal_Z_Position_Current = iGlobal_Z_Position_Current - 1; 
                else: #UP
                    iGlobal_Z_Position_Current = iGlobal_Z_Position_Current + 1;
                
                #Exit of anyone stops stepping
                if iGlobal_Currently_Stepping == FALSE: #should always be true here in the i stepper loop
                    print("%%%%%----Terminating Stepper Process midStep:",i," at PositionZ:",iGlobal_Z_Position_Current," Height:%.2f" %  ((iGlobal_Z_Position_Current / iSteps_Per_100_Microns) / 100.0),"----%%%%%%%%%%%");
                    i = iSteps;
                    #Disable Stepper driver
                    self.stepperEnable(FALSE);
                    #iGlobal_Currently_Stepping = FALSE;
                    self.led_button_A_green(LED_OFF);
                    self.led_button_B_blue(LED_OFF);
                    return;
                    
                #Make sure printing has not been canceled:
                if bPrinting_State_Driving_Stepper == 1 and (bPrinting_State_Printing_Cancel == 1 or bPrinting_State_Printing == 0): 
                    print("!!!===!!!Terminating Stepper Process in stepperStep at Step:",i,"!!!===!!!");
                    i = iSteps;
                    #Disable Stepper driver
                    self.stepperEnable(FALSE);
                    iGlobal_Currently_Stepping = FALSE;
                    #bPrinting_State_Printing_Cancel = 0;
                    bPrinting_State_Printing = 0;
                    self.led_button_A_green(LED_OFF);
                    self.led_button_B_blue(LED_OFF);
                    return;
                
                if bStepper_Acceleration_Enabled == 'true' and fPulse_Width_Z_Adj_For_Acceleration > fPulse_Width_Z:
                    #!!!!!!Accelerate!!!!!!!!!!!!!!!!!!!!!!!!!!!!!! http://www.ti.com/lit/an/slyt482/slyt482.pdf
                    fAccelerated_Delay = fAccelerated_Delay - fAcceleration_Constant_Local
                    fPulse_Width_Z_Adj_For_Acceleration = fAccelerated_Delay
                    #print(">:>:> accel>> step:",i," fAccelerated_Delay:",fAccelerated_Delay," fPulse_Width_Z_Adj_For_Acceleration:",fPulse_Width_Z_Adj_For_Acceleration)
                    if fPulse_Width_Z_Adj_For_Acceleration < fPulse_Width_Z:
                            fPulse_Width_Z_Adj_For_Acceleration = fPulse_Width_Z; #never let the accel or decel calc be less than the orig set delay
                            #print(">:>:>:>:> Acceleration Complete: Step:",i," fPulse_Width_Z_Adj_For_Acceleration=:",fPulse_Width_Z_Adj_For_Acceleration);
                
                if(bStepper_Drive_ULN2003 == False):
                    #====================================================================== STEPPING : DRV8834 =========================== Start
                    #A Low to High pulse transition advances the stepper by one step.
                    GPIO.output(gpio_stepper_pin_step, 1);
                    #self.led_red_B1(LED_OFF); #debug the pausing in stepper. Is it missed steps or CPU speep issues
                    #A4988 Driver needs a minum on_time of 1us : Datasheet:a4988_DMOS_microstepping_driver_with_translator
                    time.sleep(fPulse_Width_Z_Adj_For_Acceleration/2.0); #The /2.0 is because one pulse width is 2x states L then H
                    GPIO.output(gpio_stepper_pin_step, 0);
                    time.sleep(fPulse_Width_Z_Adj_For_Acceleration/2.0); 
                    #====================================================================== STEPPING  =========================== END
                else:
                    #====================================================================== STEPPING : ULN2003 =========================== Start
                    if bDirection == UP:
                        self.stepper_move_up_fullStep(1, fPulse_Width_Z_Adj_For_Acceleration)    
                        #self.stepper_move_up_fullStep(iSteps, fPulse_Width_Z_Adj_For_Acceleration/2.0)
                    else: #Down
                        self.stepper_move_down_fullStep(1, fPulse_Width_Z_Adj_For_Acceleration)
                        #self.stepper_move_down_fullStep(iSteps, fPulse_Width_Z_Adj_For_Acceleration/2.0)
                    #====================================================================== STEPPING  =========================== END
                iCntLED = iCntLED + 1
                if iCntLED > 25:
                    iCntLED = 0;
                    if bLED_State == 0:
                        bLED_State = 1;
                        if bDirection == DOWN:
                            self.led_button_A_green(LED_OFF);
                        else:
                            self.led_button_B_blue(LED_OFF);
                    else:
                        bLED_State = 0;
                        if bDirection == DOWN:
                            self.led_button_A_green(LED_ON);
                        else:
                            self.led_button_B_blue(LED_ON);
                                #
                    #Moved to stepper.Step :: stepperStep(self,iSteps,bDirection,fPulse_Width_Z):
                    #if GPIO.input(gpio_stepper_pin_button_down) == 1 : 
                        #Beep again to let them know its on AUTO
                    #    self.beep(1);
                    #    if iGlobal_Z_Position_Current > 0:  #was 0, but at boot it could be in a high state
                            #Go down to true ZERO
                            #self.stepperStep(iGlobal_Z_Position_Current,DOWN,fGlobal_Speed_Down_Fast); 
                    #        iSteps = iGlobal_Z_Position_Current
                    #        bDirection = DOWN
                    #        fPulse_Width_Z = fGlobal_Speed_Down_Fast
                    #        fPulse_Width_Z_Adj_For_Acceleration = fGlobal_Speed_Down_Fast
                    #    else:
                    #        #Go down X Steps
                            #self.stepperStep(iGlobal_Z_Manual_Button_Speed_Down_Fast,DOWN,fGlobal_Speed_Down_Fast); 
                    #        iSteps = iGlobal_Z_Manual_Button_Speed_Down_Fast
                    #        bDirection = DOWN
                    #        fPulse_Width_Z = fGlobal_Speed_Down_Fast
                    #        fPulse_Width_Z_Adj_For_Acceleration = fGlobal_Speed_Down_Fast
                    #    print("Button DOWN (HELD_DOWN) : ",iSteps," Delay:",fPulse_Width_Z)
                        
                #start_time = time.time()
                
                #elapsed_time = time.time() - start_time
                
        else: # ULN2003
            ######============================================= Start:  ULN2003 Darlington Driver  ==========================================
            print("You should never see this")
            ######============================================= End:  ULN2003 Darlington Driver  ==========================================
                
            
        #Stepping Finished
        if(bStepper_Drive_ULN2003 == False):
            GPIO.output(gpio_stepper_pin_step, 0);
        
        #print("stepperStep: fPulse_Width_Z_Adj_For_Acceleration=",fPulse_Width_Z_Adj_For_Acceleration);
        #print("stepperStep: fPulse_Width_Z_Adj_For_Acceleration=",fPulse_Width_Z_Adj_For_Acceleration);
        #If it was an auto step, then beep
        if iSteps == iGlobal_Z_Manual_Button_Speed_Up_Fast or iSteps == iGlobal_Z_Manual_Button_Speed_Up_Slow:
            self.beep(2);
        else:
            if(bBeep_After_Stepping == True):
                self.beep(1);
                bBeep_After_Stepping = False;
            
        #elapsed_time_EP = time.time() - start_time_EP
        #print("Measured Pulse Width Delay (last) |``|__|:",elapsed_time);
        #print("Total Step Time for ",iSteps, "is ", elapsed_time_EP, " :: Time/Step=", (elapsed_time_EP/iSteps)/2);
        #Disable Stepper driver
        self.stepperEnable(FALSE);
        iGlobal_Currently_Stepping = FALSE;
        if bDirection == DOWN:
            self.led_button_A_green(LED_OFF);
        else:
            self.led_button_B_blue(LED_OFF);
        elapsed_time_EP = time.time() - start_time_Stepper
        print("Stepper Driver : Elapsed Time: ",elapsed_time_EP);

    def stepperEnable(self, bEnabled): 
        global bStepper_Drive_ULN2003
        #"Enable and Disable Stepper Driver hardware aka 4988"
        if(bEnabled == 0):
            print("Turning OFF Stepper Driver");
            if(bStepper_Drive_ULN2003 == False):
                GPIO.output(gpio_stepper_pin_enable, 1);
            else: # ULN2003
                GPIO.output(gpio_stepper_pin_1, ULN2003_OFF)
                GPIO.output(gpio_stepper_pin_2, ULN2003_OFF)
                GPIO.output(gpio_stepper_pin_3, ULN2003_OFF)
                GPIO.output(gpio_stepper_pin_4, ULN2003_OFF)
            self.led_red_B1(LED_OFF);  
            #Turn off both UP and Down LEDs
            self.led_button_A_green(LED_OFF)
            self.led_button_B_blue(LED_OFF)
        
        if(bEnabled == 1):
            #print("Turning ON Stepper Driver");
            if(bStepper_Drive_ULN2003 == False):
                GPIO.output(gpio_stepper_pin_enable, 0);
            self.led_red_B1(LED_ON); 
            
    def stepper_move_down_fullStep(self, iSteps, fStep_Time):
        #GPIO.output(gpio_stepper_pin_1, ULN2003_OFF)
        #GPIO.output(gpio_stepper_pin_2, ULN2003_OFF)
        #GPIO.output(gpio_stepper_pin_3, ULN2003_OFF)
        #GPIO.output(gpio_stepper_pin_4, ULN2003_OFF)
        #fTime_Step_Delay_Local = fStep_Time * 2
        for i in range(iSteps):
            #print("u");
            GPIO.output(gpio_stepper_pin_3, ULN2003_OFF)
            GPIO.output(gpio_stepper_pin_1, ULN2003_ON)
            time.sleep(fStep_Time/2.0)
            GPIO.output(gpio_stepper_pin_2, ULN2003_OFF)
            GPIO.output(gpio_stepper_pin_4, ULN2003_ON)
            time.sleep(fStep_Time/2.0)
            GPIO.output(gpio_stepper_pin_1, ULN2003_OFF)
            GPIO.output(gpio_stepper_pin_3, ULN2003_ON)
            time.sleep(fStep_Time/2.0)
            GPIO.output(gpio_stepper_pin_4, ULN2003_OFF)
            GPIO.output(gpio_stepper_pin_2, ULN2003_ON)
            time.sleep(fStep_Time/2.0)
 
    def stepper_move_up_fullStep(self, iSteps, fStep_Time):
        #GPIO.output(gpio_stepper_pin_1, ULN2003_OFF)
        #GPIO.output(gpio_stepper_pin_2, ULN2003_OFF)
        #GPIO.output(gpio_stepper_pin_3, ULN2003_OFF)
        #GPIO.output(gpio_stepper_pin_4, ULN2003_OFF)
        #fTime_Step_Delay_Local = fStep_Time * 2
        for i in range(iSteps):
            #print("d");
            GPIO.output(gpio_stepper_pin_4, ULN2003_OFF)
            GPIO.output(gpio_stepper_pin_2, ULN2003_ON)
            time.sleep(fStep_Time/2.0)
            GPIO.output(gpio_stepper_pin_1, ULN2003_OFF)
            GPIO.output(gpio_stepper_pin_3, ULN2003_ON)
            time.sleep(fStep_Time/2.0)
            GPIO.output(gpio_stepper_pin_2, ULN2003_OFF)
            GPIO.output(gpio_stepper_pin_4, ULN2003_ON)
            time.sleep(fStep_Time/2.0)
            GPIO.output(gpio_stepper_pin_3, ULN2003_OFF)
            GPIO.output(gpio_stepper_pin_1, ULN2003_ON)
            time.sleep(fStep_Time/2.0)
            
    def stepper_move_up_halfStep(self, iSteps, fStep_Time):
        GPIO.output(gpio_stepper_pin_1, ULN2003_OFF)
        GPIO.output(gpio_stepper_pin_2, ULN2003_OFF)
        GPIO.output(gpio_stepper_pin_3, ULN2003_OFF)
        GPIO.output(gpio_stepper_pin_4, ULN2003_OFF)
        fTime_Step_Delay_Local = fStep_Time
        for i in range(iSteps):
            #print("u");
            GPIO.output(gpio_stepper_pin_1, ULN2003_OFF)
            time.sleep(fTime_Step_Delay_Local)
            GPIO.output(gpio_stepper_pin_3, ULN2003_ON)
            time.sleep(fTime_Step_Delay_Local)
            GPIO.output(gpio_stepper_pin_4, ULN2003_OFF)
            time.sleep(fTime_Step_Delay_Local)
            GPIO.output(gpio_stepper_pin_2, ULN2003_ON)
            time.sleep(fTime_Step_Delay_Local)
            GPIO.output(gpio_stepper_pin_3, ULN2003_OFF)
            time.sleep(fTime_Step_Delay_Local)
            GPIO.output(gpio_stepper_pin_1, ULN2003_ON)
            time.sleep(fTime_Step_Delay_Local)
            GPIO.output(gpio_stepper_pin_2, ULN2003_OFF)
            time.sleep(fTime_Step_Delay_Local)
            GPIO.output(gpio_stepper_pin_4, ULN2003_ON)
            time.sleep(fTime_Step_Delay_Local)
 
    def stepper_move_down_halfStep(self, iSteps, fStep_Time):
        GPIO.output(gpio_stepper_pin_1, ULN2003_OFF)
        GPIO.output(gpio_stepper_pin_2, ULN2003_OFF)
        GPIO.output(gpio_stepper_pin_3, ULN2003_OFF)
        GPIO.output(gpio_stepper_pin_4, ULN2003_OFF)
        fTime_Step_Delay_Local = fStep_Time
        for i in range(iSteps):
            #print("d");
            GPIO.output(gpio_stepper_pin_3, ULN2003_OFF)
            time.sleep(fTime_Step_Delay_Local)
            GPIO.output(gpio_stepper_pin_1, ULN2003_ON)
            time.sleep(fTime_Step_Delay_Local)
            GPIO.output(gpio_stepper_pin_4, ULN2003_OFF)
            time.sleep(fTime_Step_Delay_Local)
            GPIO.output(gpio_stepper_pin_2, ULN2003_ON)
            time.sleep(fTime_Step_Delay_Local)
            GPIO.output(gpio_stepper_pin_1, ULN2003_OFF)
            time.sleep(fTime_Step_Delay_Local)
            GPIO.output(gpio_stepper_pin_3, ULN2003_ON)
            time.sleep(fTime_Step_Delay_Local)
            GPIO.output(gpio_stepper_pin_2, ULN2003_OFF)
            time.sleep(fTime_Step_Delay_Local)
            GPIO.output(gpio_stepper_pin_4, ULN2003_ON)
            time.sleep(fTime_Step_Delay_Local)
            
    def led_red_B1(self, bState):
        "Red LED : B1"
        #print("Red")
        GPIO.output(gpio_stepper_pin_led_red_B1, bState);
        #Debug for inverted LED
        #GPIO.output(gpio_stepper_pin_led_green_B1, 1);
        #GPIO.output(gpio_stepper_pin_led_blue_B1, bState);

        
    def led_green_B1(self, bState):
        "Green LED : B1"
        #print("Green")
        GPIO.output(gpio_stepper_pin_led_green_B1, bState);
        #Debug for inverted LED
        #GPIO.output(gpio_stepper_pin_led_green_B1, 1);
        #GPIO.output(gpio_stepper_pin_led_red_B1, bState);
        #GPIO.output(gpio_stepper_pin_led_blue_B1, bState);
            
    def led_blue_B1(self, bState):
        "Blue LED : B1"
        #print("Blue")
        GPIO.output(gpio_stepper_pin_led_blue_B1, bState);
        #Debug for inverted LED
        #GPIO.output(gpio_stepper_pin_led_green_B1, 1);
        #GPIO.output(gpio_stepper_pin_led_red_B1, bState);
        
    def led_button_B_blue(self, bState):  #led_red_B2(self, bState):
        "Button B LED : Blue"
        GPIO.output(BUTTON_B_LED_BLU, bState);
    
    def led_button_A_green(self, bState):  #led_green_B2(self, bState):
        "Button A Green LED"
        #print(">>> led_button_A_green= ",bState)
        GPIO.output(BUTTON_A_LED_GRN, bState);
            
    def led_button_C_red(self, bState):  #led_blue_B2(self, bState):
        "Button C Z_Endstop Red LED"
        #GPIO.output(BUTTON_C_LED_RED, bState); #Depreciated
        
    def led_internal_red_illumination(self, bState): #use NPN_LED_ON
        "Internal Red LED"
        #GPIO.output(gpio_led_red_LCD_Illumination, bState); 
        
    def status_blink(self, iBlink_Count):
        "status_blink : Blink to let user know something is happening : For GUI"
        strBlinkCount = str(iBlink_Count)
        thread = threading.Thread(target=self.status_blink_threaded, args=(strBlinkCount))
        e = threading.Event()
        thread.start()
                
    def status_blink_threaded(self, strBlinkCount):
        "status_blink_threaded : Blink to let user know something is happening : For GUI"
        #This is threded so the user does not have to wait for the blinking to finish  
        iBlink_Count = int(strBlinkCount) #2
        #print("blink");
        for i in range(iBlink_Count):
            self.led_green_B1(LED_ON);
            time.sleep(0.2);
            self.led_green_B1(LED_OFF);
            if iBlink_Count > 0:
                time.sleep(0.1);

        
    def status_messages_to_GUI(self, strMessage):
        "Send status messages to GUI"
        sys.stdout.flush() #Flush before and after so the ARY is base 0
        time.sleep(0.2) #Needed to keep messages fome concatinating
        print("Message_GUI:" + strMessage);
        sys.stdout.flush()
        time.sleep(0.2) #Needed to keep messages fome concatinating

    def status_messages_to_JSON(self, strMessageElement, strMessageValue):
        "Send status messages to JSON"
        sys.stdout.flush() #Flush before and after so the ARY is base 0
        time.sleep(0.2) #Needed to keep messages fome concatinating
        print("Message_JSON:" + strMessageElement + ":" + strMessageValue);
        sys.stdout.flush()
        time.sleep(0.2) #Needed to keep messages fome concatinating

    def update_meta_refresh_time(self, iSeconds):
        "Updates meta refresh time"
        sys.stdout.flush() #Flush before and after so the ARY is base 0
        time.sleep(0.2) #Needed to keep messages fome concatinating
        #print("Update_Meta_Refresh:" + str(iSeconds));
        print("Update_Meta_Refresh Debug")
        sys.stdout.flush()
        time.sleep(0.2) #Needed to keep messages fome concatinating
        
    def status_messages_to_GUI_Sm_2(self, strMessage):
        "Send status messages to GUI"
        sys.stdout.flush() #Flush before and after so the ARY is base 0
        time.sleep(0.2) #Needed to keep messages fome concatinating
        print("Message_GUI_Sm_2:" + strMessage);
        sys.stdout.flush()
        time.sleep(0.2) #Needed to keep messages fome concatinating

    def status_messages_to_GUI_Print_Percentage_Completed(self, strMessage):
        "Send status messages to GUI - Print Percentage Complete"
        sys.stdout.flush() #Flush before and after so the ARY is base 0
        #Dont use large delay here, will delay the print!!!! This function is inlined from the print manager
        time.sleep(0.05) #Needed to keep messages fome concatinating
        print("Message_GUI_Print_Percentage:" + strMessage);
        sys.stdout.flush()
        time.sleep(0.05) #Needed to keep messages fome concatinating
         
    def status_messages_to_GUI_3(self, strMessage):
        "Send status messages to GUI"
        sys.stdout.flush() #Flush before and after so the ARY is base 0
        #Dont use large delay here, will delay the print!!!! This function is inlined from the print manager
        time.sleep(0.05) #Needed to keep messages fome concatinating
        print("Message_GUI_3:" + strMessage);
        sys.stdout.flush()
        time.sleep(0.05) #Needed to keep messages fome concatinating
        
    def status_messages_State_Boot(self, strMessage):
        "Send status messages to GUI"
        sys.stdout.flush() #Flush before and after so the ARY is base 0
        time.sleep(0.6) #Needed to keep messages fome concatinating
        print("Message_State_Boot:" + strMessage); 
        sys.stdout.flush()
        time.sleep(0.6) #Needed to keep messages fome concatinating
        
    def status_messages_State_General(self, strMessage):  #"Printing" "Stopped", etc //  
        "Send status messages to GUI"
        sys.stdout.flush() #Flush before and after so the ARY is base 0
        time.sleep(0.4) #Needed to keep messages fome concatinating
        print("Message_State_General:" + strMessage);
        sys.stdout.flush()
        time.sleep(0.4) #Needed to keep messages fome concatinating

    def status_messages_to_LCD(self, strMessage):
        "Send status messages to Calibration"
        sys.stdout.flush() #Flush before and after so the ARY is base 0
        time.sleep(0.2) #Needed to keep messages fome concatinating
        print("Message_LCD:" + strMessage);
        sys.stdout.flush()
        time.sleep(0.2) #Needed to keep messages fome concatinating

    def status_messages_to_Calibration(self, strMessage):
        "Send status messages to Calibration"
        sys.stdout.flush() #Flush before and after so the ARY is base 0
        time.sleep(0.2) #Needed to keep messages fome concatinating
        print("Message_Calibration:" + strMessage);
        sys.stdout.flush()
        time.sleep(0.2) #Needed to keep messages fome concatinating
    
    def status_messages_to_Pre_Calibration(self, strMessage):
        "Send status messages to Calibration"
        sys.stdout.flush() #Flush before and after so the ARY is base 0
        time.sleep(0.2) #Needed to keep messages fome concatinating
        print("Message_Pre_Calibration:" + strMessage);
        sys.stdout.flush()
        time.sleep(0.2) #Needed to keep messages fome concatinating

    def status_messages_to_Post_Calibration(self, strMessage):
        "Send status messages to Calibration"
        sys.stdout.flush() #Flush before and after so the ARY is base 0
        time.sleep(0.2) #Needed to keep messages fome concatinating
        print("Message_Post_Calibration:" + strMessage);
        sys.stdout.flush()
        time.sleep(0.2) #Needed to keep messages fome concatinating

    def status_messages_to_Power_Table(self, strMessage):
        "Send status messages to Calibration"
        sys.stdout.flush() #Flush before and after so the ARY is base 0
        time.sleep(0.4) #Needed to keep messages fome concatinating
        for i in range(0,14):
            sys.stdout.flush()
            print("Message_Power_Table:" + strMessage[i]);
            time.sleep(0.6)
            sys.stdout.flush()
        sys.stdout.flush()
        time.sleep(0.4) #Needed to keep messages fome concatinating 

    def status_messages_to_Individual_Calibration(self, strMessage):
        "Send status messages to Calibration"
        sys.stdout.flush() #Flush before and after so the ARY is base 0
        time.sleep(0.2) #Needed to keep messages fome concatinating
        print("Message_Individual:" + strMessage);
        sys.stdout.flush()
        time.sleep(0.2) #Needed to keep messages fome concatinating
        
    def beep(self, iBeep_Count):
        global bSoundEnabled
        "Beep to provide audible feedback to user"
        #Only beep if sound is enabled  //
        if bSoundEnabled:  
            fBeep_Delay = 0.05; #0.00048828125;
            for i in range(iBeep_Count):
                for s in range(1):
                    GPIO.output(gpio_sound_piezo_element, PIEZO_ON);   
                    time.sleep(fBeep_Delay)
                    GPIO.output(gpio_sound_piezo_element, PIEZO_OFF); 
                    time.sleep(fBeep_Delay)
                #delay between chirps
                #time.sleep(0.200);
            #Make sure the element is off
            #GPIO.output(gpio_sound_piezo_element, PIEZO_OFF); 
        
    def buttonEventHandler_down (self, iGPIO_PIN): # Dont move stepper until button is released. At button release determine if it was a short or long press.
        "DOWN button event"
        global State_stepperEnable_Last
        global start_time_Button_Down
        global bBeep_After_Stepping
        global bLong_Press_Down
        global iOne_Layer_Of_Steps
        self.led_button_A_green(LED_ON);
        bBeep_After_Stepping = True;
        
        #Determine if its a PRESS or RELEASE of button
        time.sleep(0.05) #debounce to let GPIO change? : TEST
        if GPIO.input(gpio_stepper_pin_button_down) == 1 :
            print ("handling DOWN button event : PRESSED")  
            self.beep(1);
            start_time_Button_Down = time.time() 
            #Check for UP and Down button simutanious pressing:
            #if GPIO.input(gpio_stepper_pin_button_up) == 1 :
                #Both buttons pressed, ignore DOWN
            #    print("Down and Up both pressed, ignoring Down")
            #    return;
            if bPrinting_State_Printing == 1:
                print("exiting Button UP Handler to stop print Job")
                self.fcnCancel_Print_Job();
                #EXIT
                return;
            #If currently stepping, stop:
            iGlobal_Currently_Stepping = False
            #If button is held down, continue to move Z
            time.sleep(0.5); # a debounce delay 
            if GPIO.input(gpio_stepper_pin_button_down) == 1 :
                #Beep again to let them know its on AUTO 
                #start_time_Button_Down = 999
                bLong_Press_Down = True
                self.beep(2);
                if iGlobal_Z_Position_Current > 0:  #was 0, but at boot it could be in a high state
                    #Go down to true ZERO
                    self.stepperStep(iGlobal_Z_Position_Current,DOWN,fGlobal_Speed_Down_Fast); 
                else:
                    #Go down X Steps
                    self.stepperStep(iGlobal_Z_Manual_Button_Speed_Down_Fast,DOWN,fGlobal_Speed_Down_Fast); 
            time.sleep(1.2); # a debounce delay
            if GPIO.input(gpio_stepper_pin_button_down) == 1 and GPIO.input(gpio_stepper_pin_button_up) == 1 :
                #Both buttons pressed - Process the UP event.
                print("buttonEventHandler_down : Down and Up both pressed, processing Down Both Button Event")
                print("==================================================ShutDown printer NOW=============================")
                self.led_button_A_green(LED_ON);
                self.led_button_B_blue(LED_ON);
                self.beep(15);
                time.sleep(0.2);
                self.shutdown_rpi();
                time.sleep(0.1) #debounce
                return;

        else:
            elapsed_time_EP = time.time() - start_time_Button_Down
            self.led_button_A_green(LED_OFF);
            print ("handling DOWN button event : RELEASED : bLong_Press_Down=",bLong_Press_Down, " : Hold_Time=",elapsed_time_EP)
            if(bLong_Press_Down == True):
                bLong_Press_Down = False
                #start_time_Button_Down = 0
                print("Long Press : DOWN")
                #self.beep(1);

            else:
                print("Quick press : DOWN")
                #if bPrinting_State_Printing == 1:
                #    self.fcnCancel_Print_Job();
                #    return;#EXIT
                bStepperEnable_TMP = State_stepperEnable_Last; #Save stepper enable state
                self.stepperEnable(TRUE);
                self.stepperStep(iOne_Layer_Of_Steps,DOWN,fGlobal_Speed_Down_Slow); #(Steps,Direction)
        
        
    def buttonEventHandler_up (self, iGPIO_PIN): # Dont move stepper until button is released. At button release determine if it was a short or long press. >> UP
        "UP button event"
        global State_stepperEnable_Last
        global start_time_Button_Up
        global bBeep_After_Stepping
        global bLong_Press_Up
        global iOne_Layer_Of_Steps
        self.led_button_B_blue(LED_ON);
        bBeep_After_Stepping = True;

        #Determine if its a PRESS or RELEASE of button 
        time.sleep(0.05) #debounce to let GPIO change? : TEST
        if GPIO.input(gpio_stepper_pin_button_up) == 1 :
            print ("handling UP button event : PRESSED")  
            self.beep(1);
            start_time_Button_Up = time.time() 
            if bPrinting_State_Printing == 1: 
                print("exiting Button UP Handler to stop print Job")
                self.fcnCancel_Print_Job();
                #EXIT
                return;
            #If currently stepping, stop:
            iGlobal_Currently_Stepping = False
            #If button is held down, continue to move Z
            time.sleep(0.5); # a debounce delay 
            if GPIO.input(gpio_stepper_pin_button_up) == 1 :
                #Beep again to let them know its on AUTO 
                #start_time_Button_Up = 999
                bLong_Press_Up = True
                self.beep(2);
                self.stepperStep(iGlobal_Z_Manual_Button_Speed_Up_Fast,UP,fGlobal_Speed_Up_Fast); 

            time.sleep(1.5); # a debounce delay
            if GPIO.input(gpio_stepper_pin_button_down) == 1 and GPIO.input(gpio_stepper_pin_button_up) == 1 :
                #Both buttons pressed - Process the UP event.
                print("buttonEventHandler_up : Down and Up both pressed, processing Down Both Button Event")
                print("==================================================ShutDown printer NOW=============================")
                self.led_button_A_green(LED_ON);
                self.led_button_B_blue(LED_ON);
                self.beep(15);
                time.sleep(0.2);
                self.shutdown_rpi();
                time.sleep(0.1) #debounce
                return;
            if GPIO.input(gpio_stepper_pin_button_print) == 1 and GPIO.input(gpio_stepper_pin_button_up) == 1 :
                #Both buttons pressed
                print("buttonEventHandler_up : Print and Up both pressed, processing Show Network Info On Nano LCD")
                #print("=============================================================================")
                start_time_Button_Print = 999 #to stop the printer from printing
                self.beep(3);
                time.sleep(0.2);
                self.beep(2);
                self.load_splash_screen();
                time.sleep(0.1) #debounce
                self.beep(1);
                return;
            
                    

        else:
            elapsed_time_EP = time.time() - start_time_Button_Up
            self.led_button_B_blue(LED_OFF);
            print ("handling UP button event : RELEASED : Hold_Time=",elapsed_time_EP)
            if(bLong_Press_Up == True):
                bLong_Press_Up = False
                #start_time_Button_Up = 0
                print("Long Press : UP")
                #self.beep(1);

            else:
                print("Quick Press : UP")
                #if bPrinting_State_Printing == 1:
                #    self.fcnCancel_Print_Job();
                #    return;#EXIT
                bStepperEnable_TMP = State_stepperEnable_Last; #Save stepper enable state
                self.stepperEnable(TRUE);
                self.stepperStep(iOne_Layer_Of_Steps,UP,fGlobal_Speed_Up_Slow); #(Steps,Direction)
        
    def fcnCancel_Print_Job(self):
        "Cancel Print Job"
        global bPrinting_State_Waiting_For_Platform_To_Reach_Bottom
        bPrinting_State_Waiting_For_Platform_To_Reach_Bottom = 0;
        
        self.status_messages_to_GUI("Printing Canceled")
        global bPrinting_State_Printing
        global bPrinting_State_Printing_Cancel 
        self.controlLED_UV(UV_LED_OFF);
        self.stepperEnable(FALSE);
        #self.moveZtoExtractPosition();
        if bPrinting_State_Printing:
          print("---------------------------Already Printing - Cancel Print--------------------")
        else:
          print("---------------------------Was not Printing - Cancel Print anyway --------------------")
        bPrinting_State_Printing = 0;
        bPrinting_State_Printing_Cancel = 1;
        self.led_blue_B1(LED_OFF);# turn the  LED off
        self.status_messages_to_GUI("Stopped");
        
 
        
    def buttonEventHandler_print (self, iGPIO):
        "PRINT/Pause/Cancel button event"
        global strPrint_File_SVG
        print ("handling PRINT/Pause/Cancel button event : Printing file:[" + strPrint_File_SVG + "]")
        global bPrinting_State_Printing
        global bPrinting_State_Printing_Cancel     
        global bPrinting_State_Waiting_For_Platform_To_Reach_Bottom
        global bPrinting_Option_Direct_Print_With_Z_Homing
        global bUse_Endstop
        global start_time_Button_Print
        
        time.sleep(0.05) #debounce to let GPIO change? : TEST
        
        self.led_button_A_green(LED_OFF);
        self.led_button_B_blue(LED_OFF);
        
        #Determine if its a PRESS or RELEASE of button
        #time.sleep(0.05) #debounce to let GPIO change? : TEST
        
        #Determine if its a PRESS or RELEASE of button
        if GPIO.input(gpio_stepper_pin_button_print) == 1 :
            print ("handling Print button event : PRESSED")  
            self.beep(1);
            start_time_Button_Print = time.time() 
            time.sleep(5.0); # a debounce delay 
            if GPIO.input(gpio_stepper_pin_button_print) == 1 :
                #Beep again to let them know its on accepted the long delay  
                start_time_Button_Print = 999
                self.beep(4);
        else:
            #Button RELEASED
            print ("handling PRINT/Pause/Cancel button event ::  RELEASED")
            elapsed_time_EP = time.time() - start_time_Button_Up
            if(start_time_Button_Print == 999):
                start_time_Button_Print = 0
                print("Long Press : Print : maybe try WPS")
                self.led_green_B1(LED_ON)
                self.beep(4);
                time.sleep(0.2);
                #self.shutdown_rpi();
                #Run WPS Pushbutton on strongest SSID signal that also supports WPS. Do this from wps.sh
                strScript_Full_Path = "/home/pi/ibox/wps.sh"
                try:
                    p = subprocess.Popen(strScript_Full_Path, shell=True, stdout=subprocess.PIPE)
                except OSError:
                    print ("Could not run the script: " + strScript_Full_Path)
                    #exit(1) #Why exit???
                out, err = p.communicate()
                print("\n" + str(out))
                print("I assume the script ran as expected : wait 10 sec and update screen")
                for i in range(11):
                    for z in range(3):
                        time.sleep(0.2)
                        if z == 0:
                            self.led_red_B1(LED_ON);
                            self.led_green_B1(LED_OFF);
                            self.led_blue_B1(LED_OFF);
                        if z == 1:
                            self.led_red_B1(LED_OFF);
                            self.led_green_B1(LED_ON);
                            self.led_blue_B1(LED_OFF);
                        if z == 2:
                            self.led_red_B1(LED_OFF);
                            self.led_green_B1(LED_OFF);
                            self.led_blue_B1(LED_ON);
                    
                self.beep(3);
                self.load_splash_screen();
                

            else:
                print("Print: Quick Press : Print :: strPrint_File_SVG=" + strPrint_File_SVG)
                # Set last file as the one to print
                self.set_to_be_printed_file_names_and_paths( strPrint_File_SVG );
                #print ("handling PRINT/Pause/Cancel button event :: RELEASED :: strPrint_File_SVG=" + strPrint_File_SVG)
                self.print_command_manager(); #was strPrint_File_SVG)
    
    def shutdown_rpi(self):
        command = "/usr/bin/sudo /sbin/shutdown -h now"
        import subprocess
        process = subprocess.Popen(command.split(), stdout=subprocess.PIPE)
        output = process.communicate()[0]
        print(output)
    
    def restart_rpi(self):
        command = "/usr/bin/sudo /sbin/shutdown -r now"
        import subprocess
        process = subprocess.Popen(command.split(), stdout=subprocess.PIPE)
        output = process.communicate()[0]
        print(output)
    
    def count_files_in_directory(path,extension):  #***NOT USING
        "count files in directory"
        list_dir = []
        list_dir = os.listdir(path)
        count = 0
        for file in list_dir:
            if file.endswith(extension): # eg: '.txt'
                count += 1
        return count
  
    def print_command_manager (self): #, myid, stop): #aka print_manager or print manager
        "print_command_manager"
        global strPrint_File_SVG
        global bPrinting_State_Printing
        global bPrinting_State_Printing_Cancel     
        global bPrinting_State_Waiting_For_Platform_To_Reach_Bottom
        global bPrinting_Option_Direct_Print_With_Z_Homing
        global bUse_Endstop
        global iNumber_Of_Layers
        global strDashBeforeNumbers
        global iGlobal_Currently_Stepping
        
        #print ("print_command_manager : Printing file:[" + strPrint_File_SVG + "] from Dir[" + strLayerImageDir + "] : ID=[" + str(myid) + "] : stop=[" + str(stop) + "]")
        print ("print_command_manager : Printing file:[" + strPrint_File_SVG + "] from Dir[" + strLayerImageDir + "]");
        bEndstop_On_Z_Actuated = FALSE #Reset Endstop Trigger


        #Step2 Count files  
        #iFilesCounted = self.count_files_in_directory(strLayerImageDir,".png")
        list_dir = []
        list_dir = os.listdir(strLayerImageDir)
        count = 0
        for file in list_dir:
            if file.endswith("0.png"): # eg: '.txt'
                count += 1
            elif file.endswith("1.png"):
                count += 1
            elif file.endswith("2.png"):
                count += 1
            elif file.endswith("3.png"):
                count += 1
            elif file.endswith("4.png"):
                count += 1
            elif file.endswith("5.png"):
                count += 1
            elif file.endswith("6.png"):
                count += 1
            elif file.endswith("7.png"):
                count += 1
            elif file.endswith("8.png"):
                count += 1
            elif file.endswith("9.png"):
                count += 1

        iFilesCounted = count
        print("iFilesCounted=",iFilesCounted," : in dir:" + strLayerImageDir)


        #Step3 Make sure the first and last file exist, well we have checked the first file above, so just check the last
        #But you want to start printing asap, so either wait for all files to convert (blocking Thread), or not check if files and dir exists
        '''
        strPad = ""
        if strDashBeforeNumbers == "":
            strPad = "000"
            if iFilesCounted > 9:
                strPad = "00"
            if iFilesCounted > 99:
                strPad = "0"
            if iFilesCounted > 999:
                strPad = ""
        
        strFileTmp_LastFile = strLayerImageDir + "/" + strLayerImageName_Base + strDashBeforeNumbers + strPad + strFilesCounted + ".png"
        '''
        strFilesCounted = str(iFilesCounted-1) #-1 because its a base 0 counter 0=1 9=10
        

        strDashBeforeNumbers = "";
        strPad = "000"
        if iFilesCounted > 9:
            strPad = "00"
        if iFilesCounted > 99:
            strPad = "0"
        if iFilesCounted > 999:
            strPad = ""
        strFileTmp_LastFile = strLayerImageDir + "/" + strLayerImageName_Base + strDashBeforeNumbers + strPad + strFilesCounted + ".png"
        print("Checking to see of the file format is FileName0001.xxx or FileName_1.xxx :: File=[" + strFileTmp_LastFile + "]")
        if os.path.exists(strFileTmp_LastFile) == True:
            strDashBeforeNumbers = "";
        else:
            strDashBeforeNumbers = "_";

        print('Set strDashBeforeNumbers=[' + strDashBeforeNumbers + ']');
        

        
        strPad = ""
        if strDashBeforeNumbers == "":
          strPad = "000"
          if iFilesCounted > 9:
              strPad = "00"
          if iFilesCounted > 99:
              strPad = "0"
          if iFilesCounted > 999:
              strPad = ""
        strFileTmp_LastFile = strLayerImageDir + "/" + strLayerImageName_Base + strDashBeforeNumbers + strPad + strFilesCounted + ".png"       
         
        #Step 1 : Verify files and directories exist : may as well count layers and verify that as well
        #strLayerImageDir = strDirToMake :: ## i.e. /home/pi/ibox/uploads/data/Bunny10 
        #strLayerImageName_Base = strPrint_File_SVG_noExt :: i.e. "Bunny10 
        if os.path.isdir(strLayerImageDir) == True:
            print("Dir exists: " + strLayerImageDir)
        else:
            print(">>>>>>>>> ERROR >>>> Dir DOES NOT exist: " + strLayerImageDir + "....  EXITING")
            self.beep(3);
            return
        if strDashBeforeNumbers == "":
            strFileTmp = strLayerImageDir + "/" + strLayerImageName_Base + strDashBeforeNumbers + "0000.png"
        else:
            strFileTmp = strLayerImageDir + "/" + strLayerImageName_Base + strDashBeforeNumbers + "0.png"
        if os.path.exists(strFileTmp) == True:
            print("First File exists: " + strFileTmp)
        else:
            print(">>>>>>  ERROR >>>> First File DOES NOT exist: " + strFileTmp + "....  EXITING")
            self.beep(3);
            return
        
        if os.path.exists(strFileTmp_LastFile) == True:
            print("Last File exists: " + strFileTmp_LastFile)
        else:
            print("Last File DOES NOT exist: " + strFileTmp_LastFile + "....  EXITING")
            self.beep(3);
            #//Note but dont exit return
        
        iNumber_Of_Layers = iFilesCounted - 1 #base 0 (lastlayerprintissue)
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
