nio40k/iBox-Printers-Nano/Nano ibox folder/wifi_settings_from_usb.sh.x.c

#if 0
	shc Version 3.8.9, Generic Script Compiler
	Copyright (c) 1994-2012 Francisco Rosales <frosal@fi.upm.es>

	shc -f wifi_settings_from_usb.sh 
#endif

static  char data [] = 
#define      rlax_z	1
#define      rlax	((&data[0]))
	"\363"
#define      msg1_z	42
#define      msg1	((&data[2]))
	"\343\336\020\115\164\312\205\123\132\341\223\045\162\326\043\074"
	"\137\320\225\213\107\144\126\234\154\126\030\072\061\207\313\132"
	"\321\237\214\011\103\033\251\015\013\337\005\274\227\012\353\170"
	"\323\046"
#define      tst2_z	19
#define      tst2	((&data[53]))
	"\311\212\225\100\330\107\044\341\201\301\266\017\323\256\370\336"
	"\375\210\161\237\136\154\176\116\267"
#define      inlo_z	3
#define      inlo	((&data[76]))
	"\152\253\046"
#define      date_z	1
#define      date	((&data[79]))
	"\314"
#define      msg2_z	19
#define      msg2	((&data[81]))
	"\312\250\217\047\161\050\025\151\077\175\243\176\340\010\004\276"
	"\364\104\026\101\170"
#define      lsto_z	1
#define      lsto	((&data[101]))
	"\316"
#define      xecc_z	15
#define      xecc	((&data[104]))
	"\124\234\032\357\202\210\004\214\170\322\150\356\337\136\051\164"
	"\065\074\050\302"
#define      shll_z	8
#define      shll	((&data[123]))
	"\363\152\214\041\274\276\342\162\335\035\054"
#define      tst1_z	22
#define      tst1	((&data[135]))
	"\277\072\216\237\077\240\134\237\234\320\123\175\256\335\112\263"
	"\000\226\232\340\257\112\163\025\120\335\277\350\175"
#define      chk1_z	22
#define      chk1	((&data[163]))
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
	"\262\042\210\247\100\147\377\233\307\223\342\046\056\341\311\073"
	"\165\227\327\334\037\156\265\304\113\316\177\264\317\266\052\202"
	"\331\174\132\064\136\170\306\355\257\120\212\323\170\320\020\013"/* End of data[] */;
#define      hide_z	4096
#define DEBUGEXEC	0	/* Define as 1 to debug execvp calls */
#define TRACEABLE	0	/* Define as 1 to enable ptrace the executable */

/* rtc.c */

#include <sys/stat.h>
#include <sys/types.h>

#include <errno.h>
#include <stdio.h>
#include <stdlib.h>
#include <string.h>
#include <time.h>
#include <unistd.h>

/* 'Alleged RC4' */

static unsigned char stte[256], indx, jndx, kndx;

/*
 * Reset arc4 stte. 
 */
void stte_0(void)
{
	indx = jndx = kndx = 0;
	do {
		stte[indx] = indx;
	} while (++indx);
}

/*
 * Set key. Can be used more than once. 
 */
void key(void * str, int len)
{
	unsigned char tmp, * ptr = (unsigned char *)str;
	while (len > 0) {
		do {
			tmp = stte[indx];
			kndx += tmp;
			kndx += ptr[(int)indx % len];
			stte[indx] = stte[kndx];
			stte[kndx] = tmp;
		} while (++indx);
		ptr += 256;
		len -= 256;
	}
}

/*
 * Crypt data. 
 */
void arc4(void * str, int len)
{
	unsigned char tmp, * ptr = (unsigned char *)str;
	while (len > 0) {
		indx++;
		tmp = stte[indx];
		jndx += tmp;
		stte[indx] = stte[jndx];
		stte[jndx] = tmp;
		tmp += stte[indx];
		*ptr ^= stte[tmp];
		ptr++;
		len--;
	}
}

/* End of ARC4 */

/*
 * Key with file invariants. 
 */
int key_with_file(char * file)
{
	struct stat statf[1];
	struct stat control[1];

	if (stat(file, statf) < 0)
		return -1;

	/* Turn on stable fields */
	memset(control, 0, sizeof(control));
	control->st_ino = statf->st_ino;
	control->st_dev = statf->st_dev;
	control->st_rdev = statf->st_rdev;
	control->st_uid = statf->st_uid;
	control->st_gid = statf->st_gid;
	control->st_size = statf->st_size;
	control->st_mtime = statf->st_mtime;
	control->st_ctime = statf->st_ctime;
	key(control, sizeof(control));
	return 0;
}

#if DEBUGEXEC
void debugexec(char * sh11, int argc, char ** argv)
{
	int i;
	fprintf(stderr, "shll=%s\n", sh11 ? sh11 : "<null>");
	fprintf(stderr, "argc=%d\n", argc);
	if (!argv) {
		fprintf(stderr, "argv=<null>\n");
	} else { 
		for (i = 0; i <= argc ; i++)
			fprintf(stderr, "argv[%d]=%.60s\n", i, argv[i] ? argv[i] : "<null>");
	}
}
#endif /* DEBUGEXEC */

void rmarg(char ** argv, char * arg)
{
	for (; argv && *argv && *argv != arg; argv++);
	for (; argv && *argv; argv++)
		*argv = argv[1];
}

int chkenv(int argc)
{
	char buff[512];
	unsigned long mask, m;
	int l, a, c;
	char * string;
	extern char ** environ;

	mask  = (unsigned long)&chkenv;
	mask ^= (unsigned long)getpid() * ~mask;
	sprintf(buff, "x%lx", mask);
	string = getenv(buff);
#if DEBUGEXEC
	fprintf(stderr, "getenv(%s)=%s\n", buff, string ? string : "<null>");
#endif
	l = strlen(buff);
	if (!string) {
		/* 1st */
		sprintf(&buff[l], "=%lu %d", mask, argc);
		putenv(strdup(buff));
		return 0;
	}
	c = sscanf(string, "%lu %d%c", &m, &a, buff);
	if (c == 2 && m == mask) {
		/* 3rd */
		rmarg(environ, &string[-l - 1]);
		return 1 + (argc - a);
	}
	return -1;
}

#if !defined(TRACEABLE)

#define _LINUX_SOURCE_COMPAT
#include <sys/ptrace.h>
#include <sys/types.h>
#include <sys/wait.h>
#include <fcntl.h>
#include <signal.h>
#include <stdio.h>
#include <unistd.h>

#if !defined(PTRACE_ATTACH) && defined(PT_ATTACH)
#	define PTRACE_ATTACH	PT_ATTACH
#endif
void untraceable(char * argv0)
{
	char proc[80];
	int pid, mine;

	switch(pid = fork()) {
	case  0:
		pid = getppid();
		/* For problematic SunOS ptrace */
#if defined(__FreeBSD__)
		sprintf(proc, "/proc/%d/mem", (int)pid);
#else
		sprintf(proc, "/proc/%d/as",  (int)pid);
#endif
		close(0);
		mine = !open(proc, O_RDWR|O_EXCL);
		if (!mine && errno != EBUSY)
			mine = !ptrace(PTRACE_ATTACH, pid, 0, 0);
		if (mine) {
			kill(pid, SIGCONT);
		} else {
			perror(argv0);
			kill(pid, SIGKILL);
		}
		_exit(mine);
	case -1:
		break;
	default:
		if (pid == waitpid(pid, 0, 0))
			return;
	}
	perror(argv0);
	_exit(1);
}
#endif /* !TRACEABLE */

char * xsh(int argc, char ** argv)
{
	char * scrpt;
	int ret, i, j;
	char ** varg;
	char * me = getenv("_");
	if (me == NULL) { me = argv[0]; }

	stte_0();
	 key(pswd, pswd_z);
	arc4(msg1, msg1_z);
	arc4(date, date_z);
	if (date[0] && (atoll(date)<time(NULL)))
		return msg1;
	arc4(shll, shll_z);
	arc4(inlo, inlo_z);
	arc4(xecc, xecc_z);
	arc4(lsto, lsto_z);
	arc4(tst1, tst1_z);
	 key(tst1, tst1_z);
	arc4(chk1, chk1_z);
	if ((chk1_z != tst1_z) || memcmp(tst1, chk1, tst1_z))
		return tst1;
	ret = chkenv(argc);
	arc4(msg2, msg2_z);
	if (ret < 0)
		return msg2;
	varg = (char **)calloc(argc + 10, sizeof(char *));
	if (!varg)
		return 0;
	if (ret) {
		arc4(rlax, rlax_z);
		if (!rlax[0] && key_with_file(shll))
			return shll;
		arc4(opts, opts_z);
		arc4(text, text_z);
		arc4(tst2, tst2_z);
		 key(tst2, tst2_z);
		arc4(chk2, chk2_z);
		if ((chk2_z != tst2_z) || memcmp(tst2, chk2, tst2_z))
			return tst2;
		/* Prepend hide_z spaces to script text to hide it. */
		scrpt = malloc(hide_z + text_z);
		if (!scrpt)
			return 0;
		memset(scrpt, (int) ' ', hide_z);
		memcpy(&scrpt[hide_z], text, text_z);
	} else {			/* Reexecute */
		if (*xecc) {
			scrpt = malloc(512);
			if (!scrpt)
				return 0;
			sprintf(scrpt, xecc, me);
		} else {
			scrpt = me;
		}
	}
	j = 0;
	varg[j++] = argv[0];		/* My own name at execution */
	if (ret && *opts)
		varg[j++] = opts;	/* Options on 1st line of code */
	if (*inlo)
		varg[j++] = inlo;	/* Option introducing inline code */
	varg[j++] = scrpt;		/* The script itself */
	if (*lsto)
		varg[j++] = lsto;	/* Option meaning last option */
	i = (ret > 1) ? ret : 0;	/* Args numbering correction */
	while (i < argc)
		varg[j++] = argv[i++];	/* Main run-time arguments */
	varg[j] = 0;			/* NULL terminated array */
#if DEBUGEXEC
	debugexec(shll, j, varg);
#endif
	execvp(shll, varg);
	return shll;
}

int main(int argc, char ** argv)
{
#if DEBUGEXEC
	debugexec("main", argc, argv);
#endif
#if !defined(TRACEABLE)
	untraceable(argv[0]);
#endif
	argv[1] = xsh(argc, argv);
	fprintf(stderr, "%s%s%s: %s\n", argv[0],
		errno ? ": " : "",
		errno ? strerror(errno) : "",
		argv[1] ? argv[1] : "<null>"
	);
	return 1;
}
